hoeken/frothfet/frothfet/FrothFET Rev F Fuse Placement.png

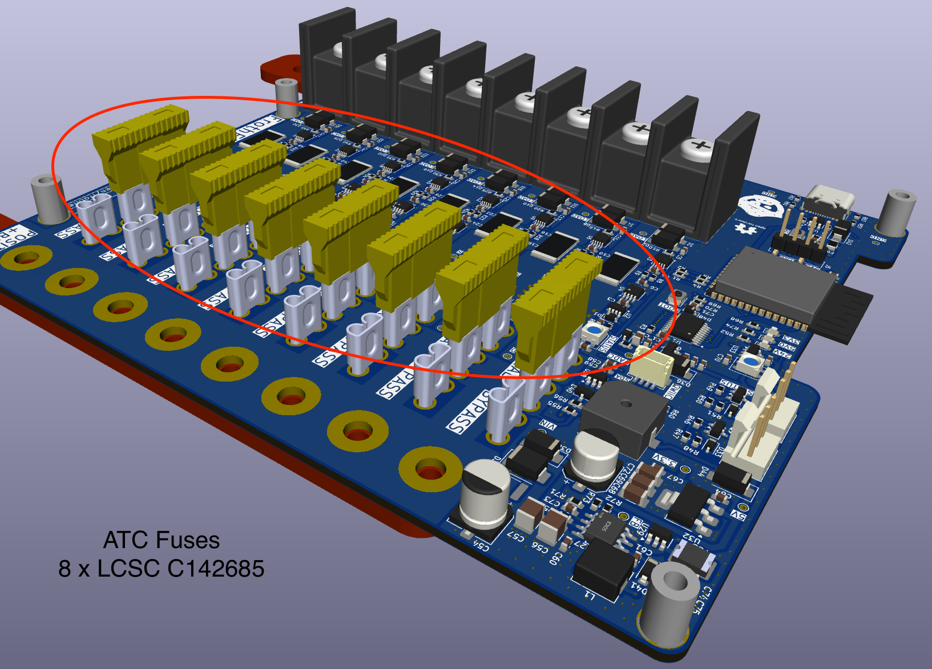
frothfet/FrothFET Rev F Fuse Placement.png
