hoeken/frothfet/frothfet/planning/ESP32-S3-DEV-KIT-N8R8-details-13.jpg

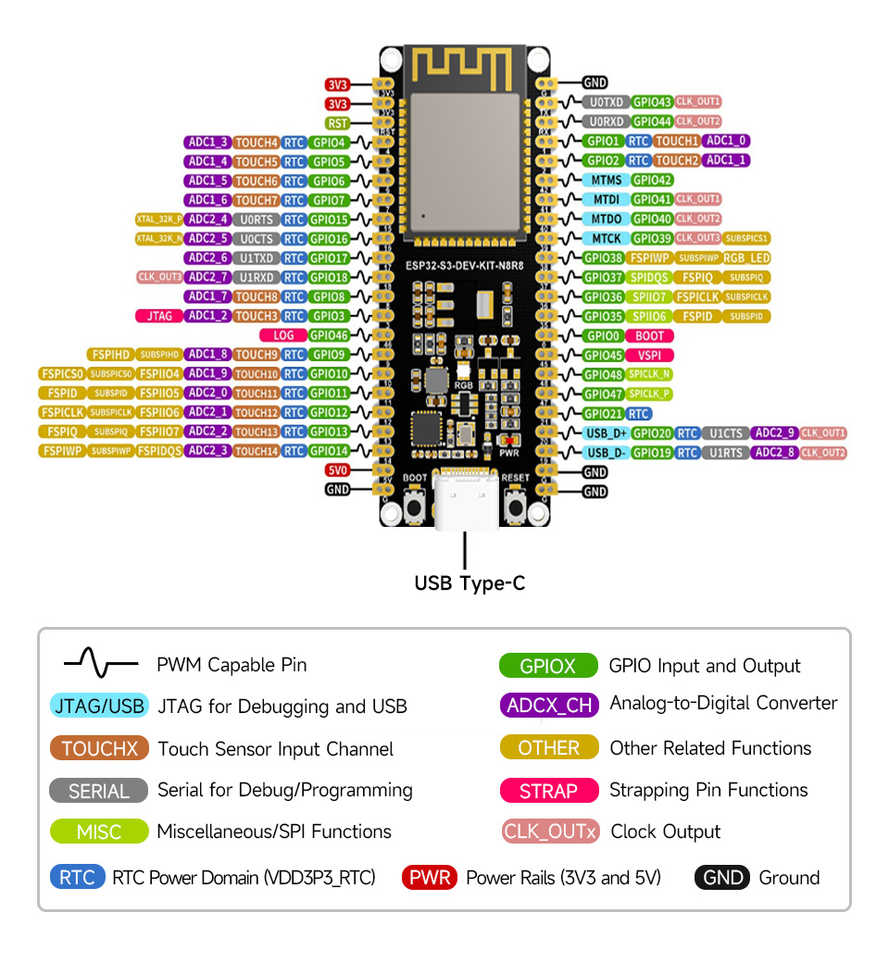
frothfet/planning/ESP32-S3-DEV-KIT-N8R8-details-13.jpg
