hoeken/frothfet/README.md

This is the hardware design repository for FrothFET.

For detailed documentation, please visit the [FrothFET documentation](https://frothfet.com).
