hoeken/frothfet/frothfet/planning/ADC chips.ods

Board/Chip | Price | Resolution | Sample Rate | Package | Supply | Arduino Sketch 8ch s/s
MCP3008 | 3.12 | 10 | 200k | DIP / SOIC | 2.7-5.5
MCP3208 | 4.97 | 12 | 100k | DIP / SOIC | 2.7-5.5 | 5755
ADS1115 | 6.46 | 16 | 860 | TINY | 2-5v | 14
ADS1015 | 3.06 | 12 | 3300 | TINY | 2-5v | 4
