hoeken/frothfet/frothfet/planning/current sense chips.ods

Board/Chip | Price | Package | Supply | Resistance | Accuracy | Bandwidth | Total
ACS724/5 | 4.36 | SOIC | 3.3v or 5v | 1.2mohm | ??? | 120kHz | $34.88
MCS1802/3 | 4.6 | SOIC | 3.3v or 5v | 0.9mohm | 2.50% | 80kHz | $36.80
TMCS1108 | 2.75 | SOIC | 3 V to 5.5 V | ??? | 1.00% | 100kHz | $22.00
CT415/CT427 | 5.91 | SOIC | 3.3v or 5v | ??? | 1.00% | 100kHz | $47.28
