hoeken/frothfet/frothfet/planning/cost reduction.ods

Sheet: Sheet1
Rev E Design |  | @100
chip | qty | cost | total
mcp3564r | 2 | $4.50 | $9.00
tmcs1108 | 8 | $1.50 | $12.00
passives | 208 | $0.01 | $2.08
total |  |  | $23.08
Rev F Design
chip | qty | cost | total
ina226 | 8 | $0.62 | $4.96
sense resistor | 8 | $0.40 | $3.20
74LVC541A | 1 | $0.20 | $0.20
LM75BDP | 8 | $0.38 | $3.04 | T1601B | DS18B20U(UMW)
total |  |  | $11.40
BTN8982TA | 8 | $2.38 | $19.04
LM74502H | 8 | $0.79 | $6.32
BSC010N04LS | 8 | $0.35 | $2.80
Infineon BTS6143D | 8 | $1.09 | $8.72
BTS50055-1TMA | 8 | $3.13 | $25.04

Sheet: FrothFET Mini
FrothFET Mini Design
chip | qty | cost | total
74LVC541A | 1 | -$0.20 | -$0.20
LM75BDP | 8 | -$0.38 | -$3.04
LM74502H | 8 | -$1.30 | -$10.40
BSC010N04LS | 8 | -$0.61 | -$4.88
T507 | 21 | -$0.04 | -$0.84
BTS724G | 4 | $1.74 | $6.96
PCA9685 | 1 | $2.55 | $2.55
total |  |  | -$9.85
