hoeken/frothfet/models/Positive Busbar Rev F.FCStd

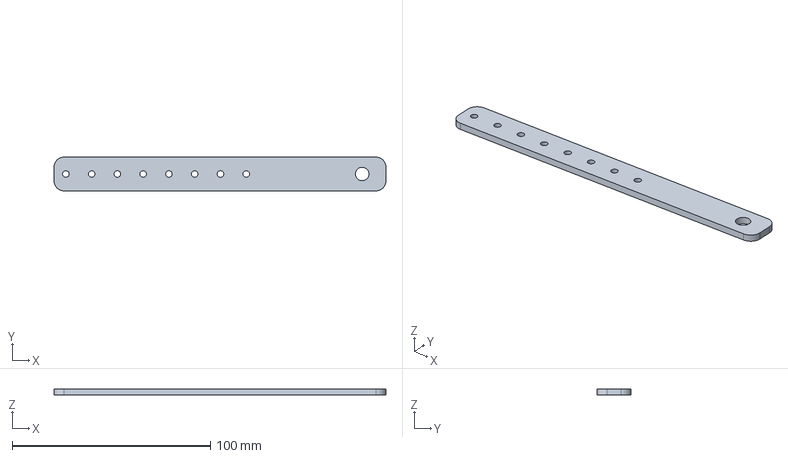
[picture p3: CAD file, 2025-10-06]
models/Positive Busbar Rev F.FCStd
167.5 x 17.0 x 3.12 mm
