hoeken/frothfet/models/Negative Busbar Rev F.FCStd

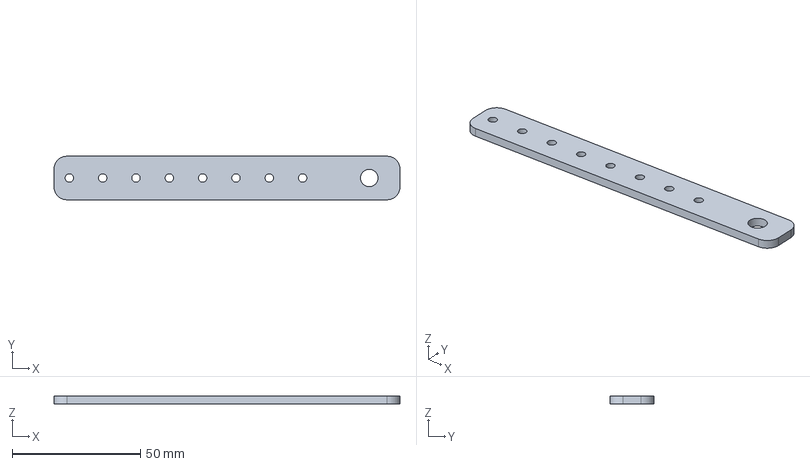
[picture p4: CAD file, 2024-11-02]
models/Negative Busbar Rev F.FCStd
135.0 x 17.0 x 3.12 mm
