hoeken/frothfet/MANUFACTURING.md

++ PCB Options

**If unspecified, use defaults:**

* PCB Color: Blue
* Surface Finish: ENIG
* Outer Copper Weight: 2oz

++ PCBA Options

**If unspecified, use defaults:**

* PCBA Type: Standard
* Bake Components: Yes
  * Comment: WS2812B-Mini (LCSC C527089)
* Depanel boards & edge rail: Yes
* PCBA Remark:
  * Please populate 8 x ATC Fuses (LCSC C142685) in NORMAL position as shown
  * Upload fuse placement image
