hoeken/frothfet/schematics/FrothFET Rev F.pdf

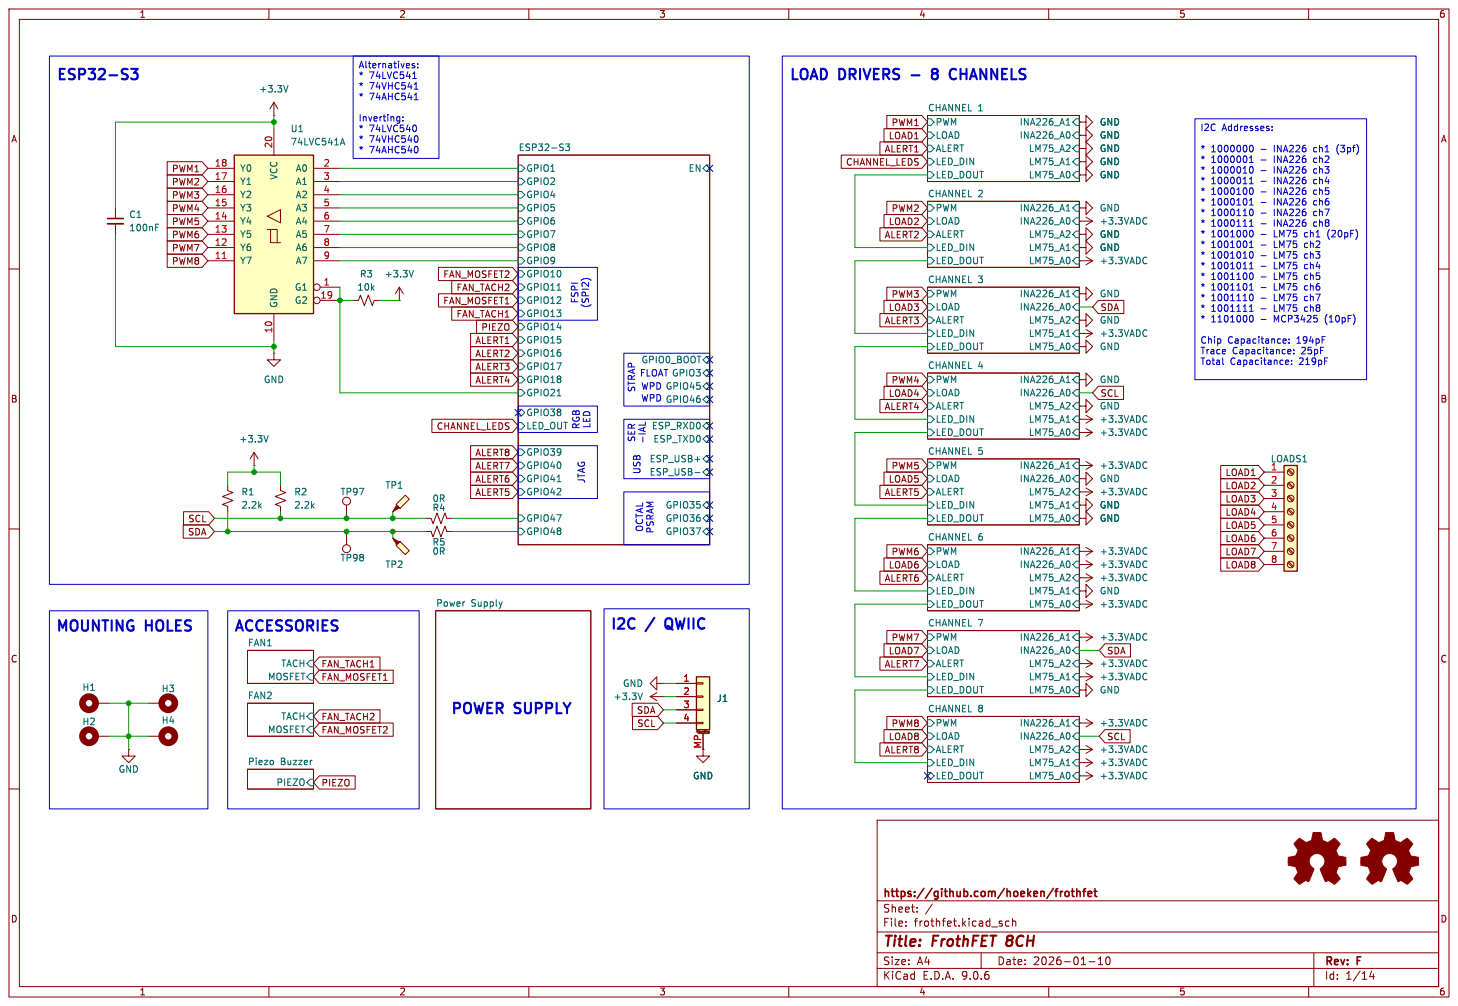
[picture p5: page 1]

File: frothfet.kicad_sch Sheet: / https://github.com/hoeken/frothfet

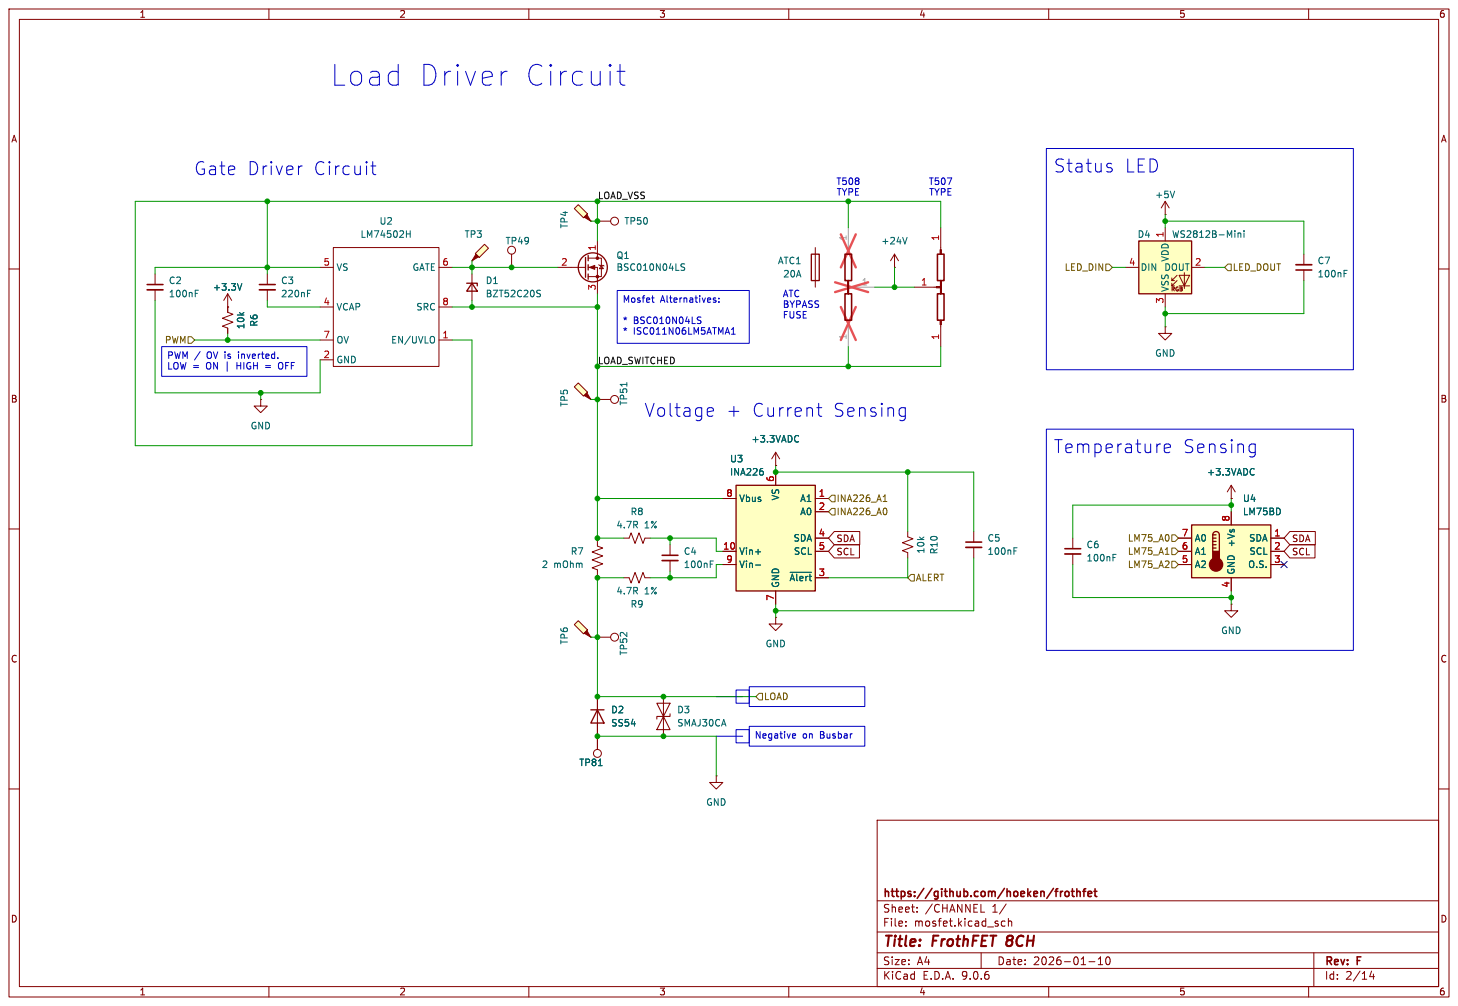
[picture p6: page 2]

T508 TYPE Load Driver Circuit
1 GND

Negative on Busbar Mosfet Alternatives: * BSC010N04LS

* ISC011N06LM5ATMA1 PWM / OV is inverted. LOW = ON | HIGH = OFF
INA226_A1 PWM

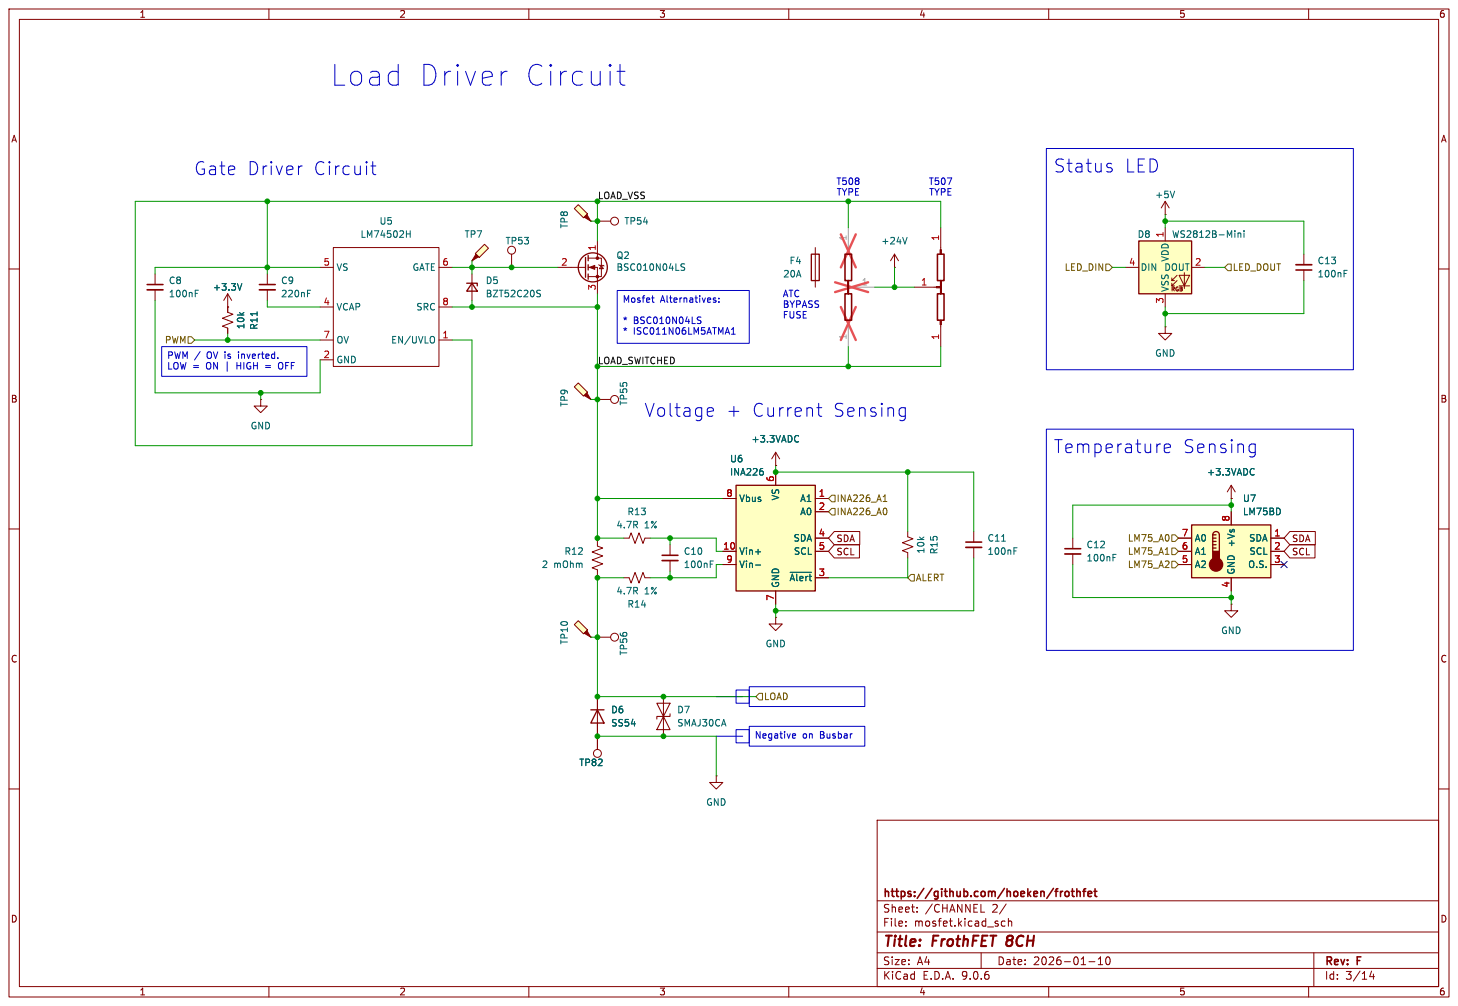
[picture p7: page 3]

T508 TYPE Load Driver Circuit
1 GND

1 3 Q2 BSC010N04LS 10k R11 VS 5 VCAP 4 OV 7 GND 2 GATE 6 SRC 8 EN/UVLO 1 U5

Negative on Busbar Mosfet Alternatives: * BSC010N04LS

* ISC011N06LM5ATMA1 PWM / OV is inverted. LOW = ON | HIGH = OFF
INA226_A1 PWM

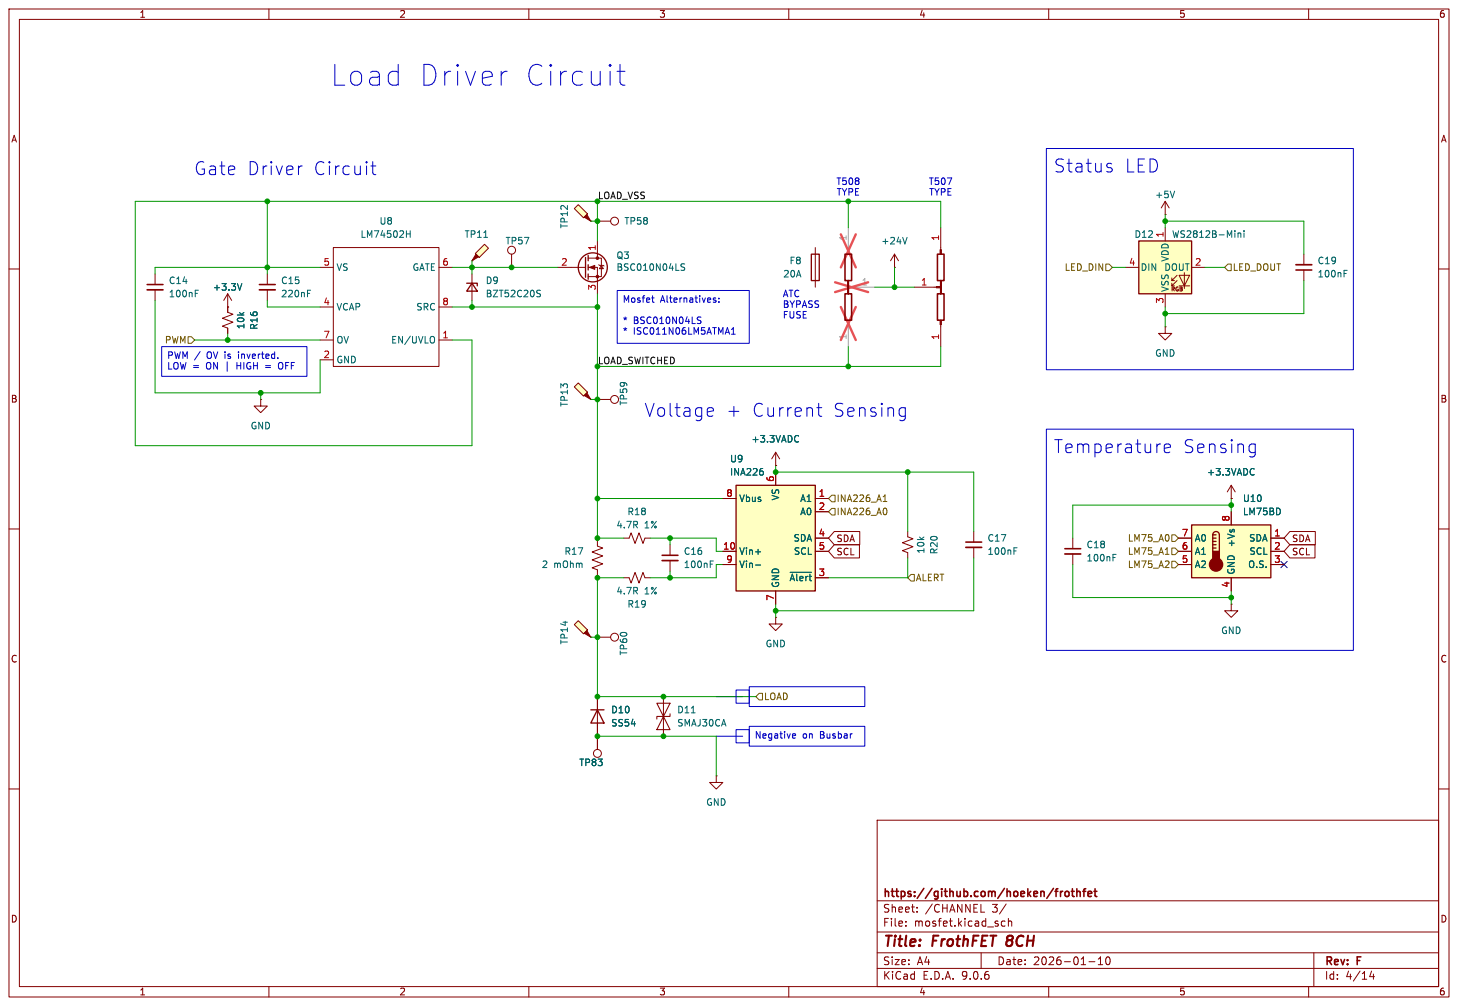
[picture p8: page 4]

T508 TYPE Load Driver Circuit
1 GND

Negative on Busbar Mosfet Alternatives: * BSC010N04LS

* ISC011N06LM5ATMA1 PWM / OV is inverted. LOW = ON | HIGH = OFF
INA226_A1 PWM

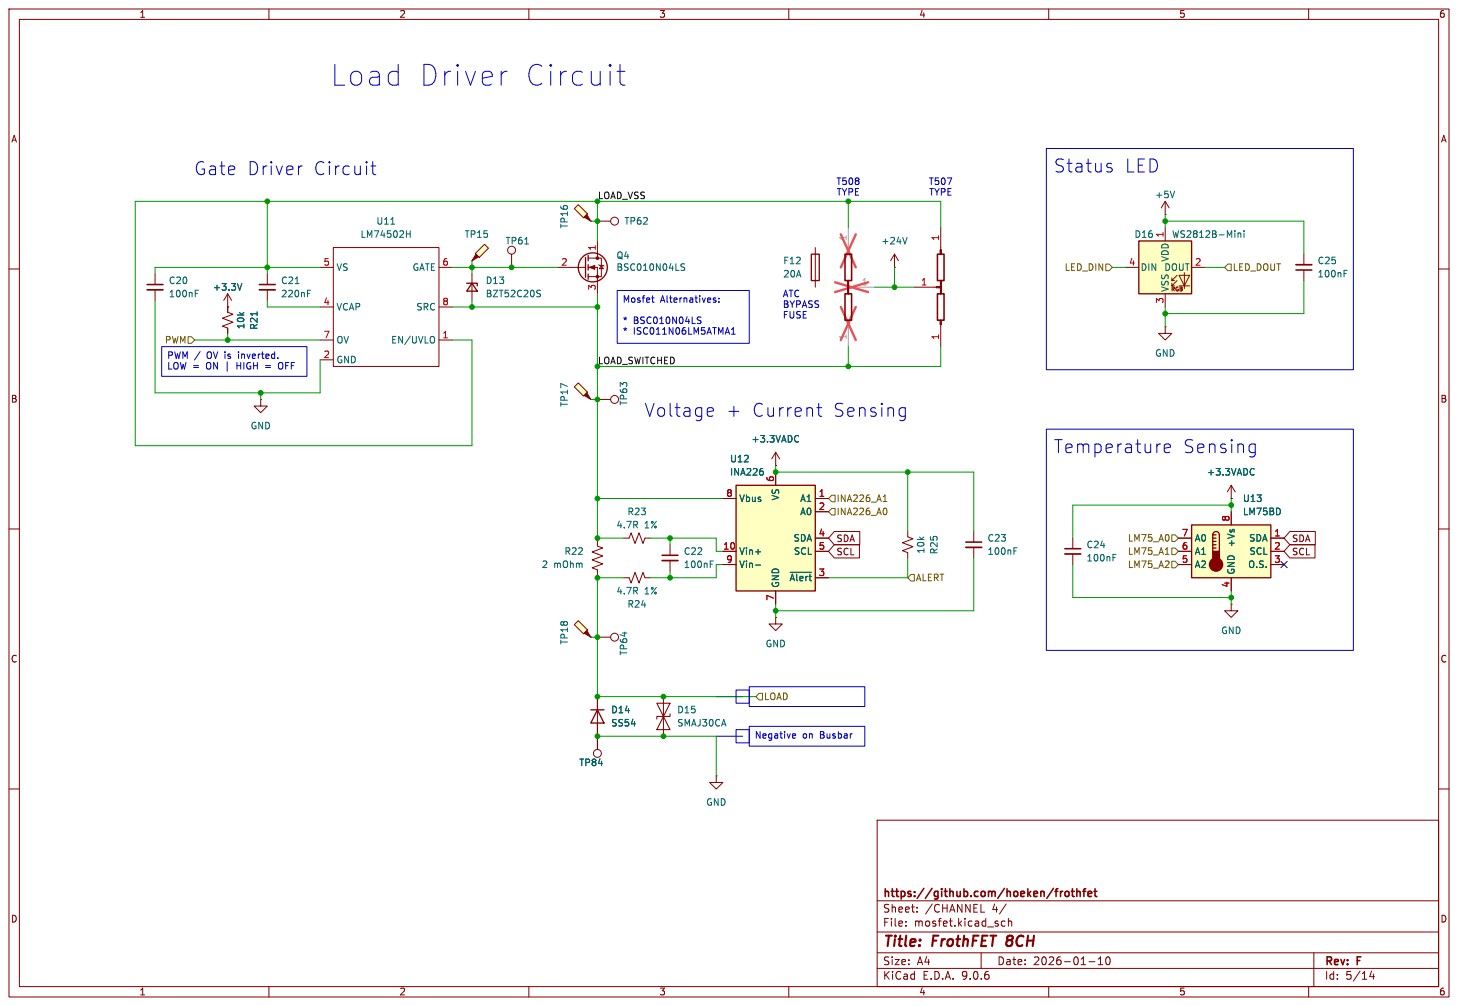
[picture p9: page 5]

T508 TYPE Load Driver Circuit
1 GND

1 3 Q4 BSC010N04LS 10k R21 VS 5 VCAP 4 OV 7 GND 2 GATE 6 SRC 8 EN/UVLO 1 U11

Negative on Busbar Mosfet Alternatives: * BSC010N04LS

* ISC011N06LM5ATMA1 PWM / OV is inverted. LOW = ON | HIGH = OFF
INA226_A1 PWM

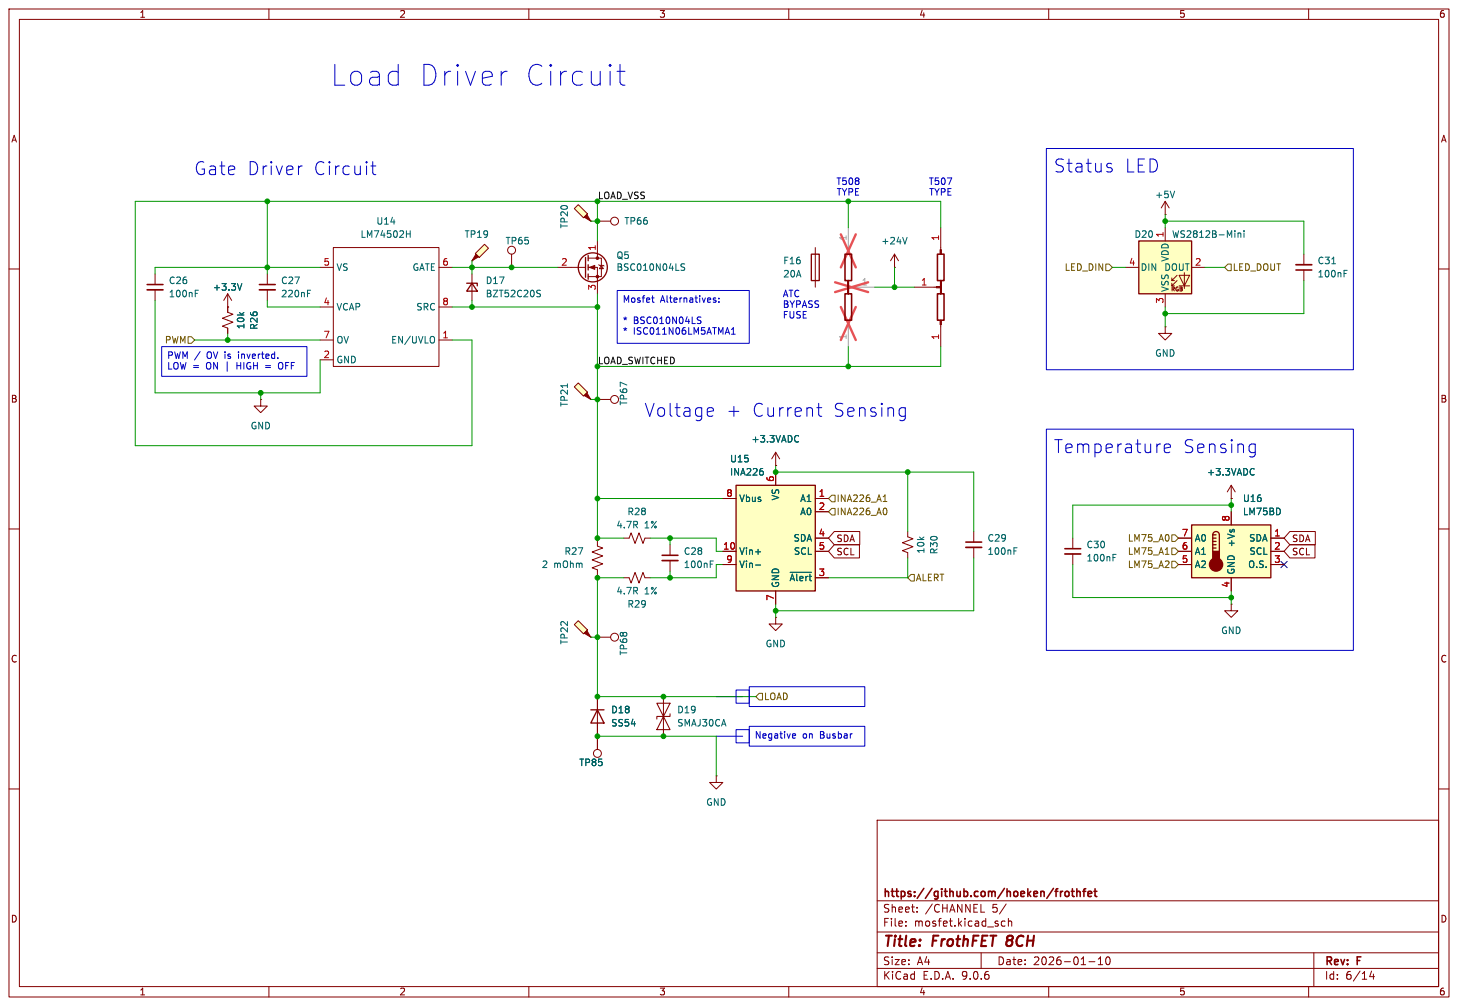
[picture p10: page 6]

T508 TYPE Load Driver Circuit
1 GND

Negative on Busbar Mosfet Alternatives: * BSC010N04LS

* ISC011N06LM5ATMA1 PWM / OV is inverted. LOW = ON | HIGH = OFF
INA226_A1 PWM

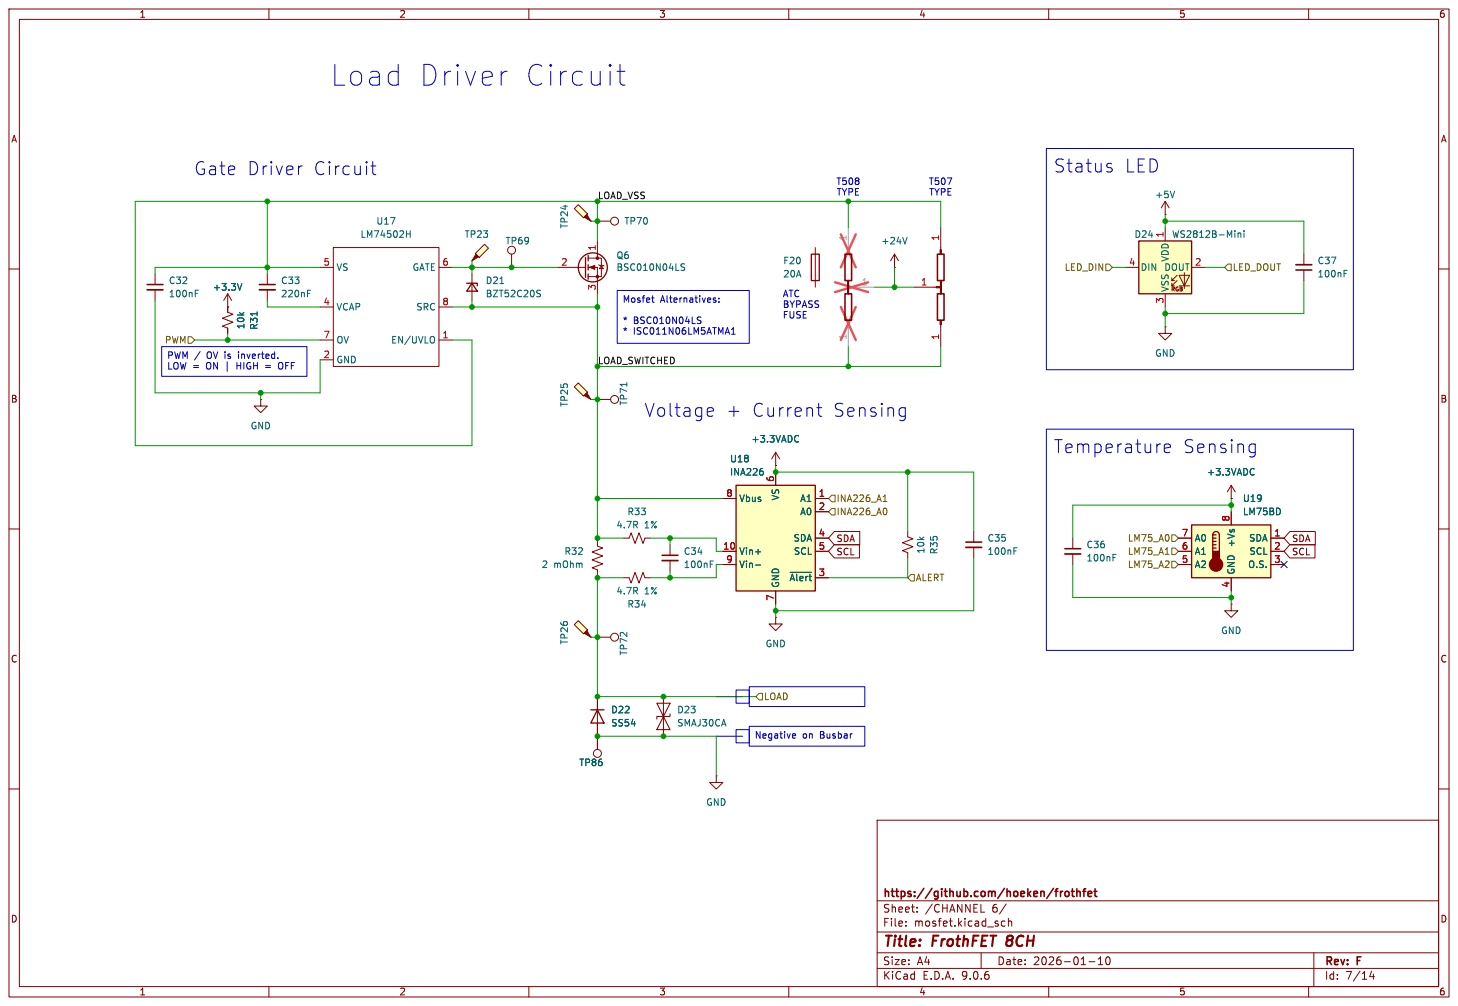
[picture p11: page 7]

T508 TYPE Load Driver Circuit
1 GND

1 3 Q6 BSC010N04LS 10k R31 VS 5 VCAP 4 OV 7 GND 2 GATE 6 SRC 8 EN/UVLO 1 U17

Negative on Busbar Mosfet Alternatives: * BSC010N04LS

* ISC011N06LM5ATMA1 PWM / OV is inverted. LOW = ON | HIGH = OFF
INA226_A1 PWM

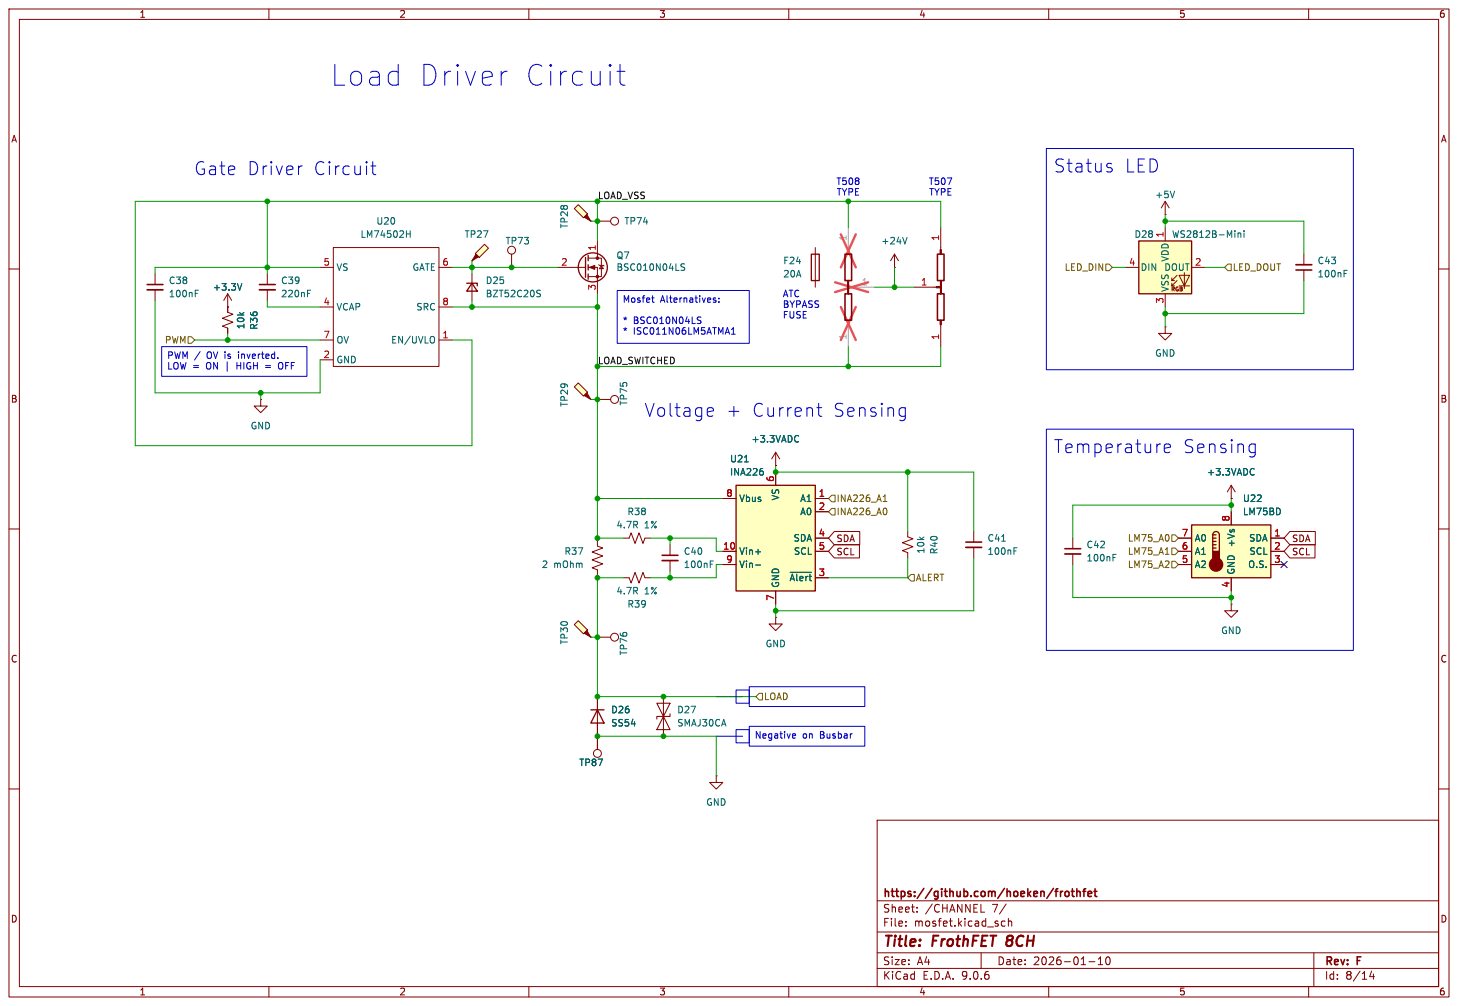
[picture p12: page 8]

T508 TYPE Load Driver Circuit
1 GND

Negative on Busbar Mosfet Alternatives: * BSC010N04LS

* ISC011N06LM5ATMA1 PWM / OV is inverted. LOW = ON | HIGH = OFF
INA226_A1 PWM

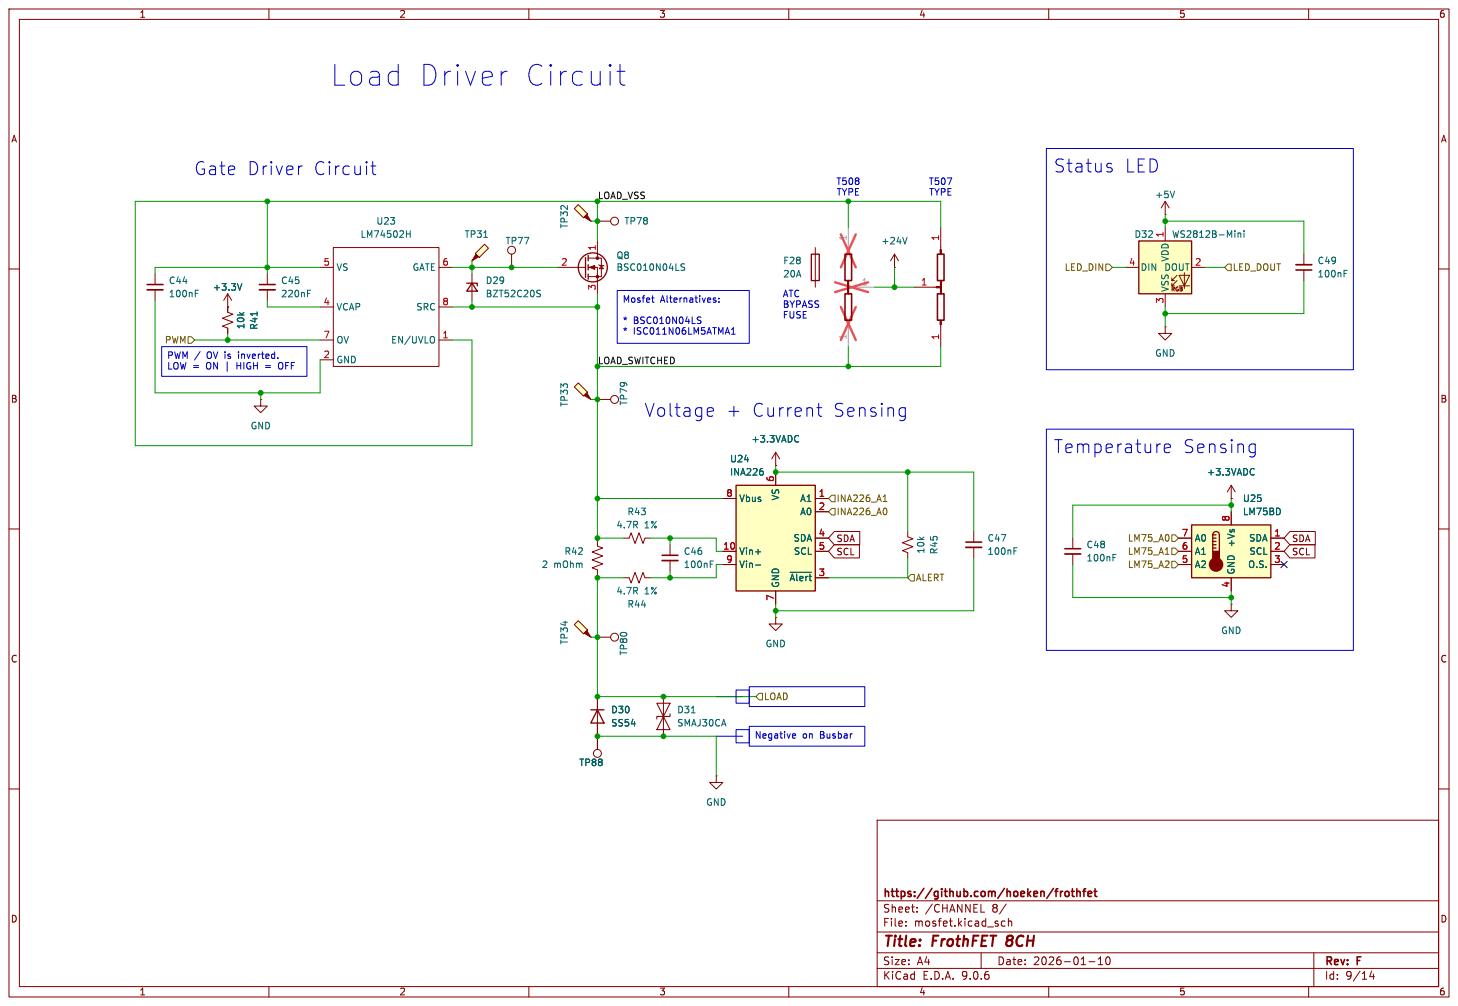
[picture p13: page 9]

T508 TYPE Load Driver Circuit
1 GND

1 3 Q8 BSC010N04LS 10k R41 VS 5 VCAP 4 OV 7 GND 2 GATE 6 SRC 8 EN/UVLO 1 U23

Negative on Busbar Mosfet Alternatives: * BSC010N04LS

* ISC011N06LM5ATMA1 PWM / OV is inverted. LOW = ON | HIGH = OFF
INA226_A1 PWM

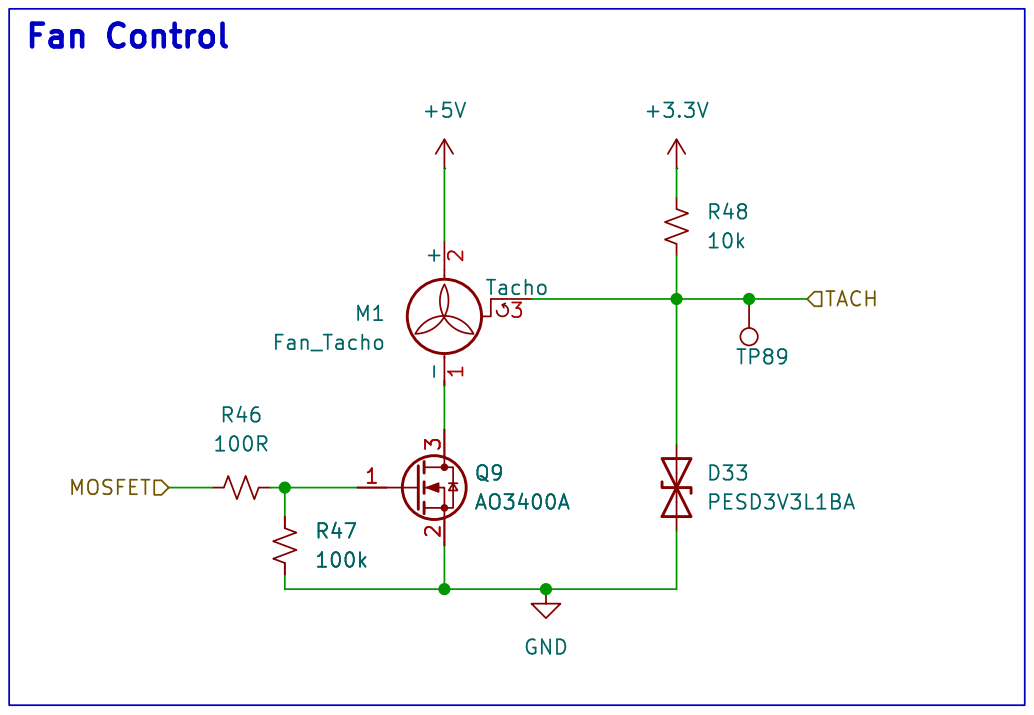
[picture p14: page 10]

File: pwm fan.kicad_sch Sheet: /FAN1/ https://github.com/hoeken/frothfet

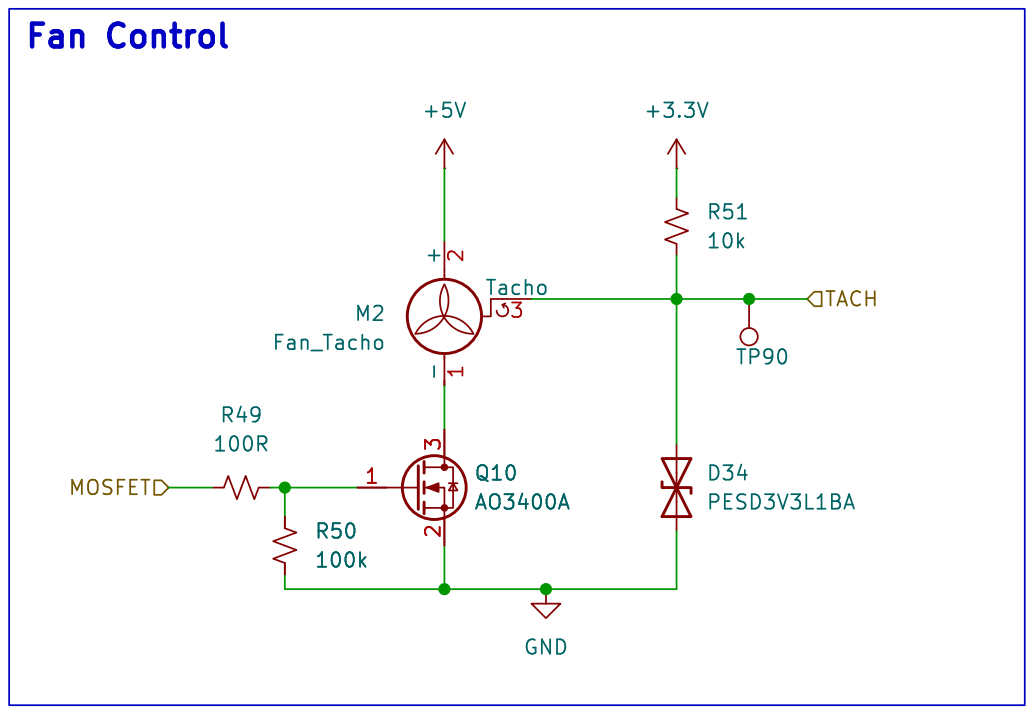
[picture p15: page 11]

File: pwm fan.kicad_sch Sheet: /FAN2/ https://github.com/hoeken/frothfet

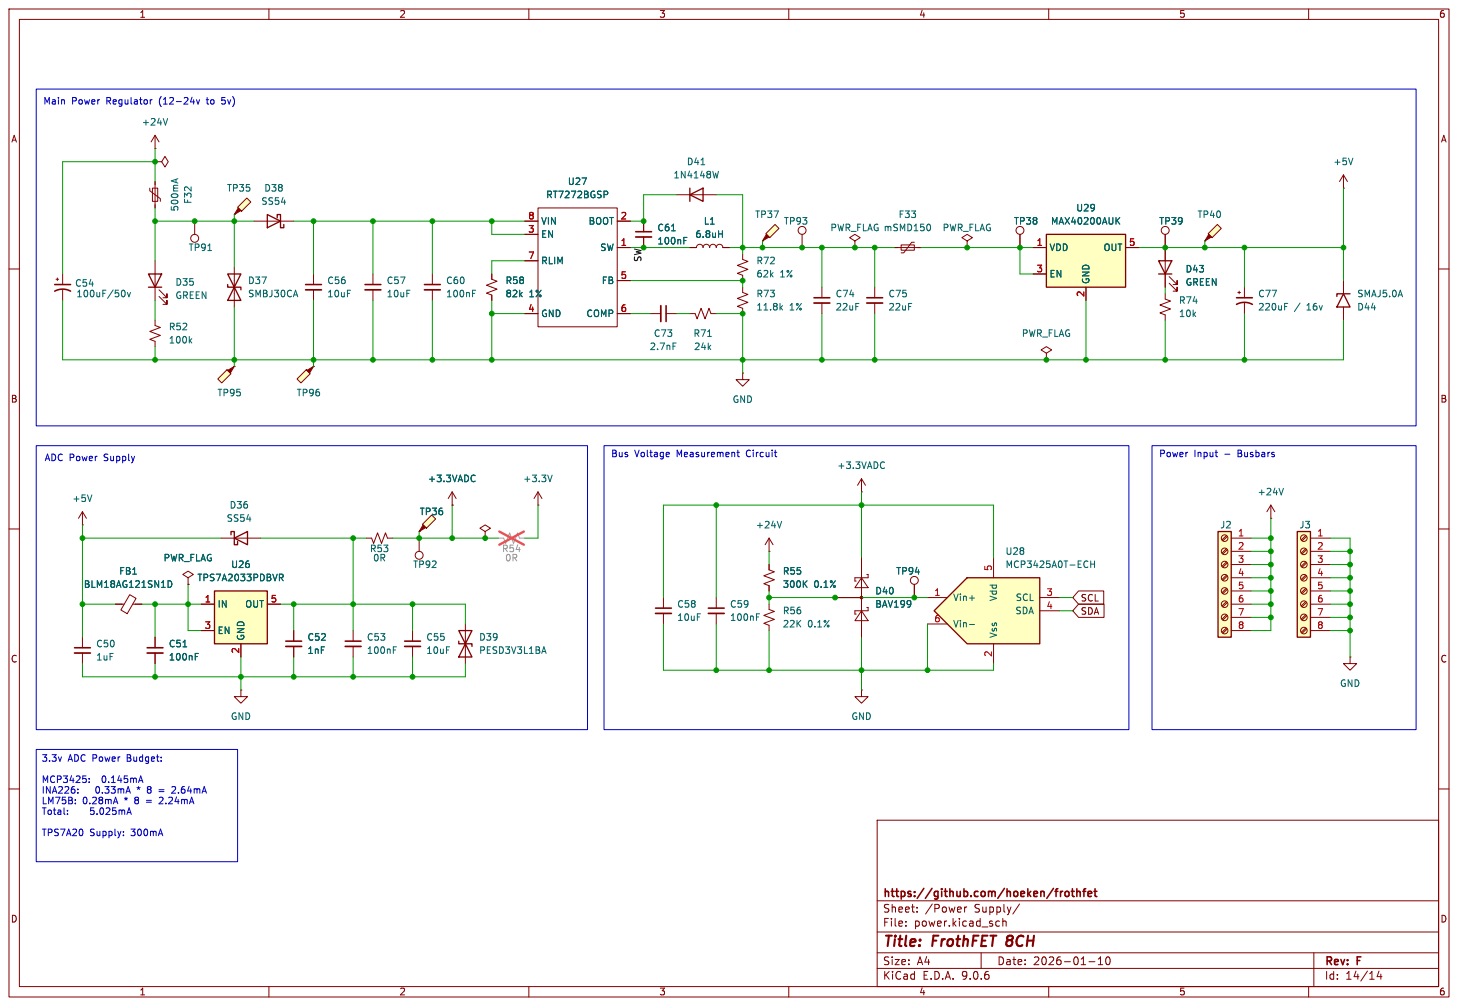
[picture p16: page 12]

5 Vss 2 SCL 3 SDA 4 U28 MCP3425A0T-ECH

https://github.com/hoeken/frothfet FB1 BLM18AG121SN1D

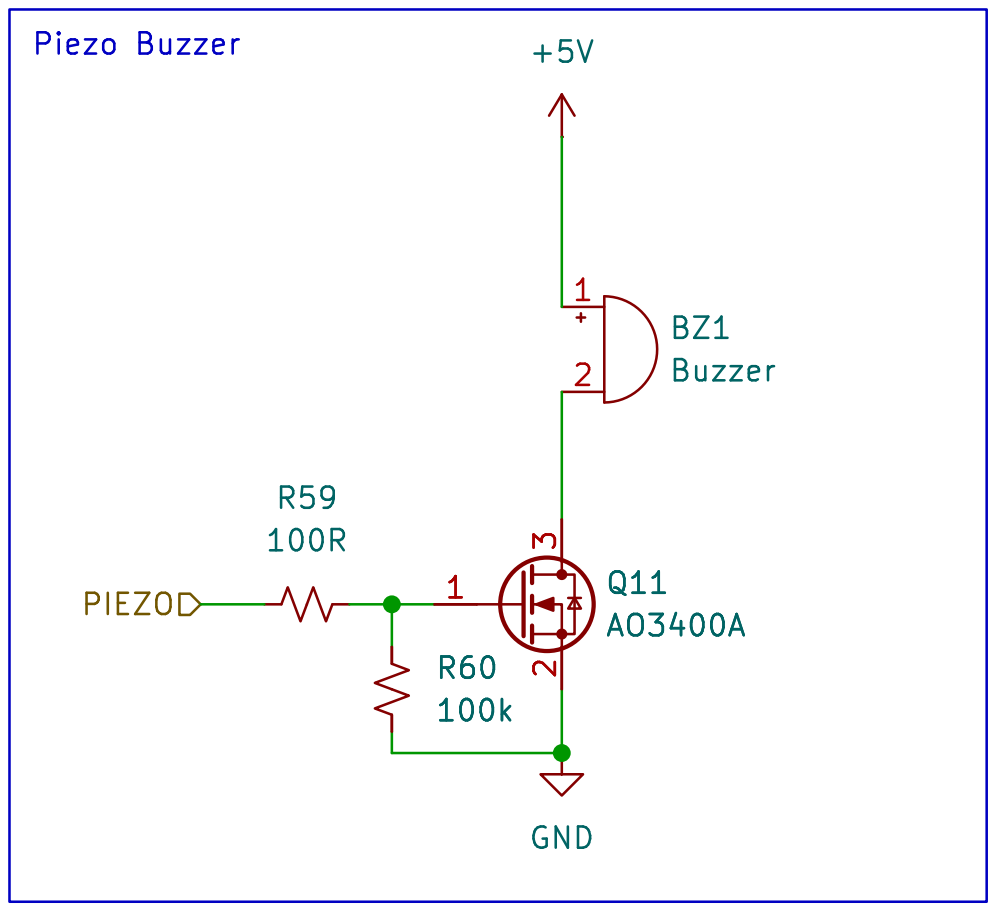
[picture p17: page 13]

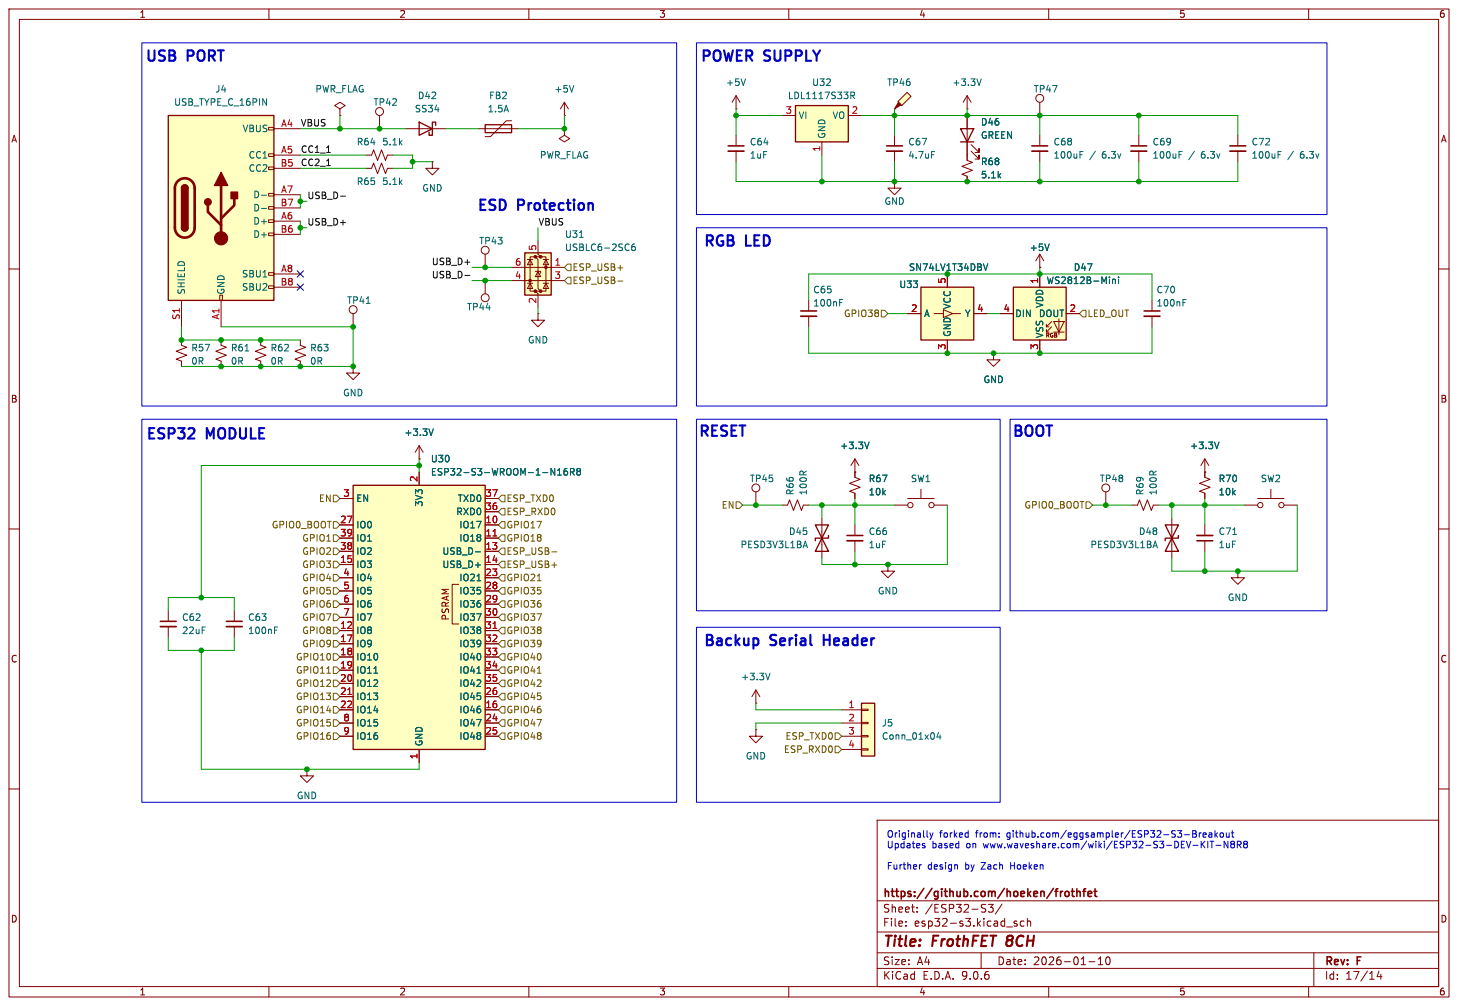
[picture p18: page 14]

Updates based on www.waveshare.com/wiki/ESP32-S3-DEV-KIT-N8R8 Further design by Zach Hoeken BOOT

File: esp32-s3.kicad_sch Sheet: /ESP32-S3/ https://github.com/hoeken/frothfet
