hoeken/frothfet/schematics/FrothFET Rev E.pdf

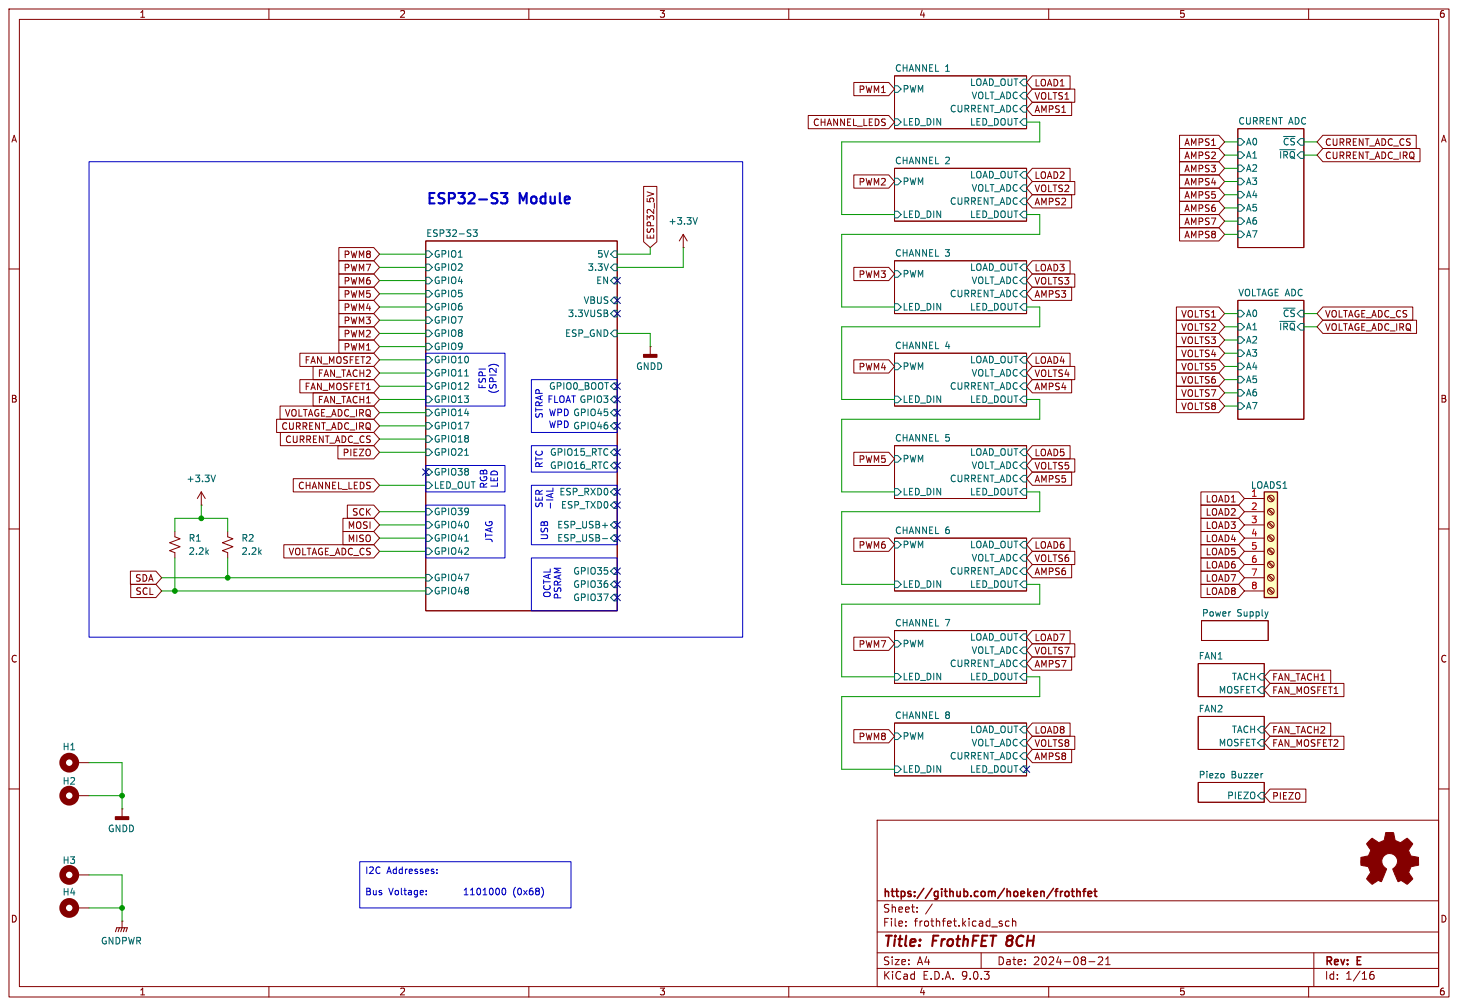
[picture p19: page 1]

VOLTS1 AMPS1
~{IRQ} CURRENT ADC MOSFET

File: frothfet.kicad_sch Sheet: / https://github.com/hoeken/frothfet

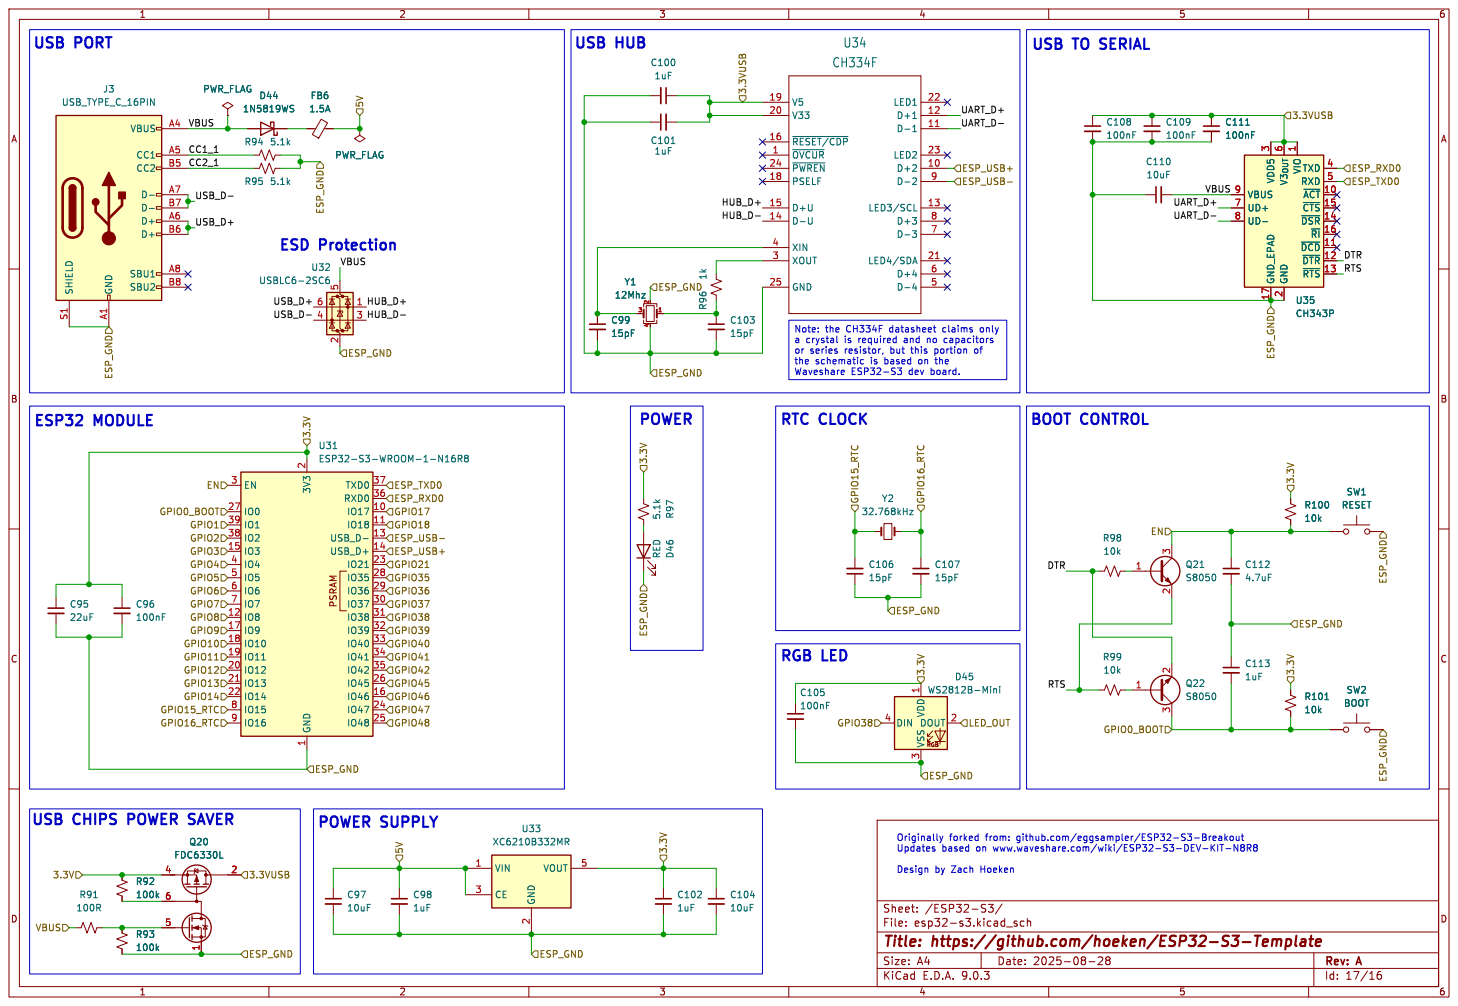
[picture p20: page 2]

1 TXD 4 RXD 5 ~{ACT} 10 ~{CTS} 15 ~{DSR} 14 ~{RI} 16 ~{DCD} 11 ~{DTR} 12 ~{RTS} 13 C111

1 TXD 4 RXD 5 ~{ACT} 10 ~{CTS} 15 ~{DSR} 14 ~{RI} 16 ~{DCD} 11 ~{DTR} 12 ~{RTS} 13 U35 CH343P C106

USB CHIPS POWER SAVER

Updates based on www.waveshare.com/wiki/ESP32-S3-DEV-KIT-N8R8 Design by Zach Hoeken

File: esp32-s3.kicad_sch Sheet: /ESP32-S3/
Id: 17/16 Title: https://github.com/hoeken/ESP32-S3-Template

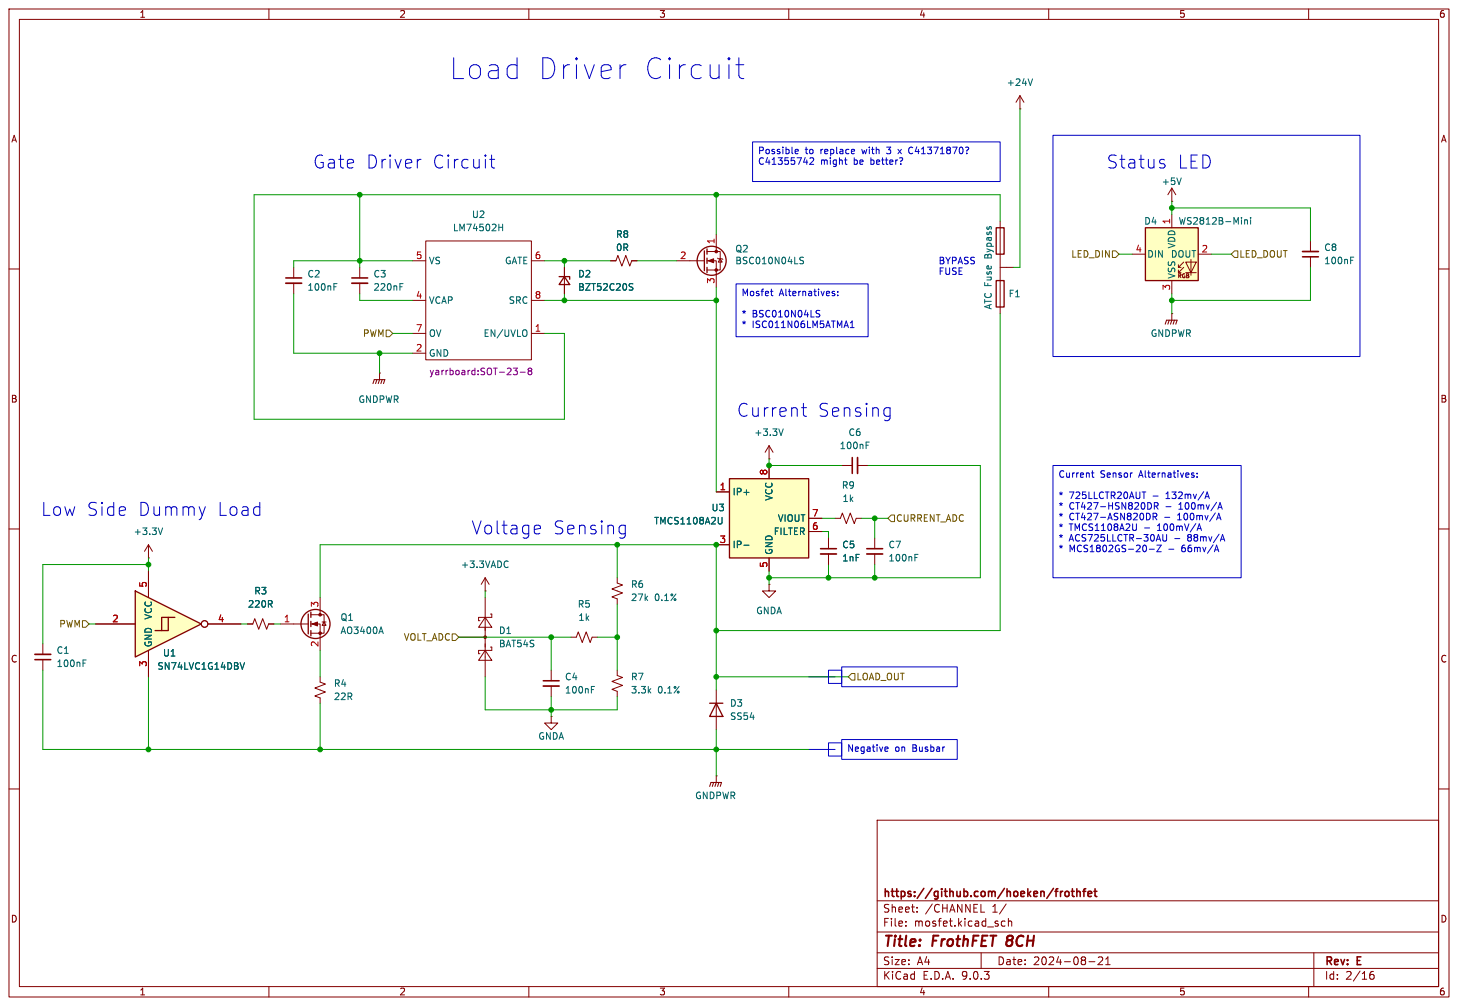
[picture p21: page 3]

Low Side Dummy Load

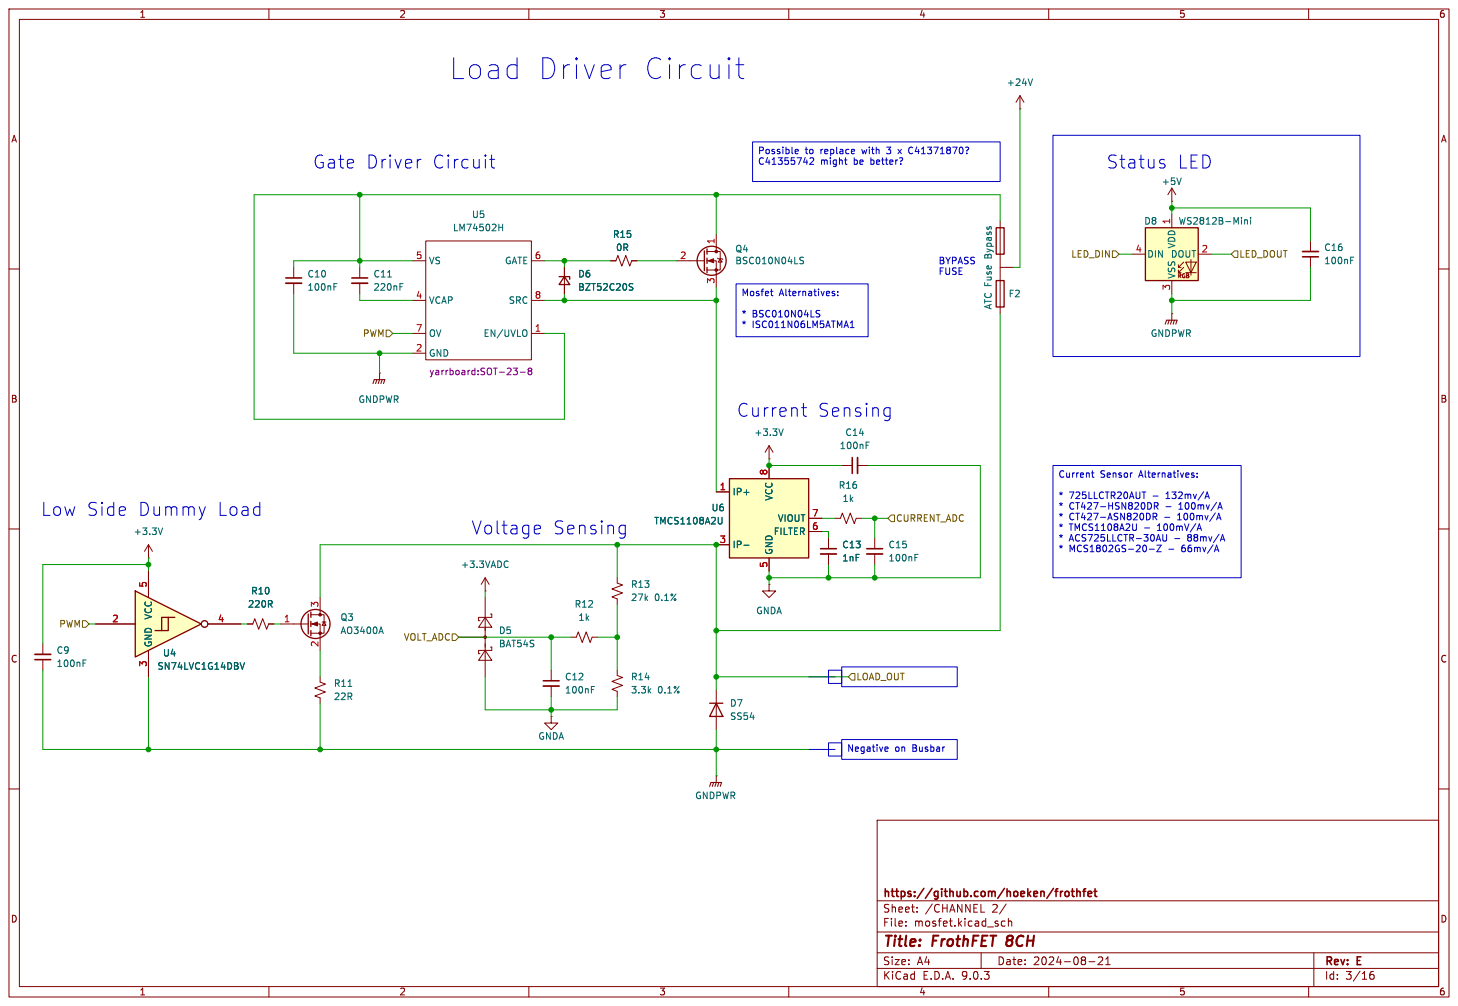
[picture p22: page 4]

Low Side Dummy Load

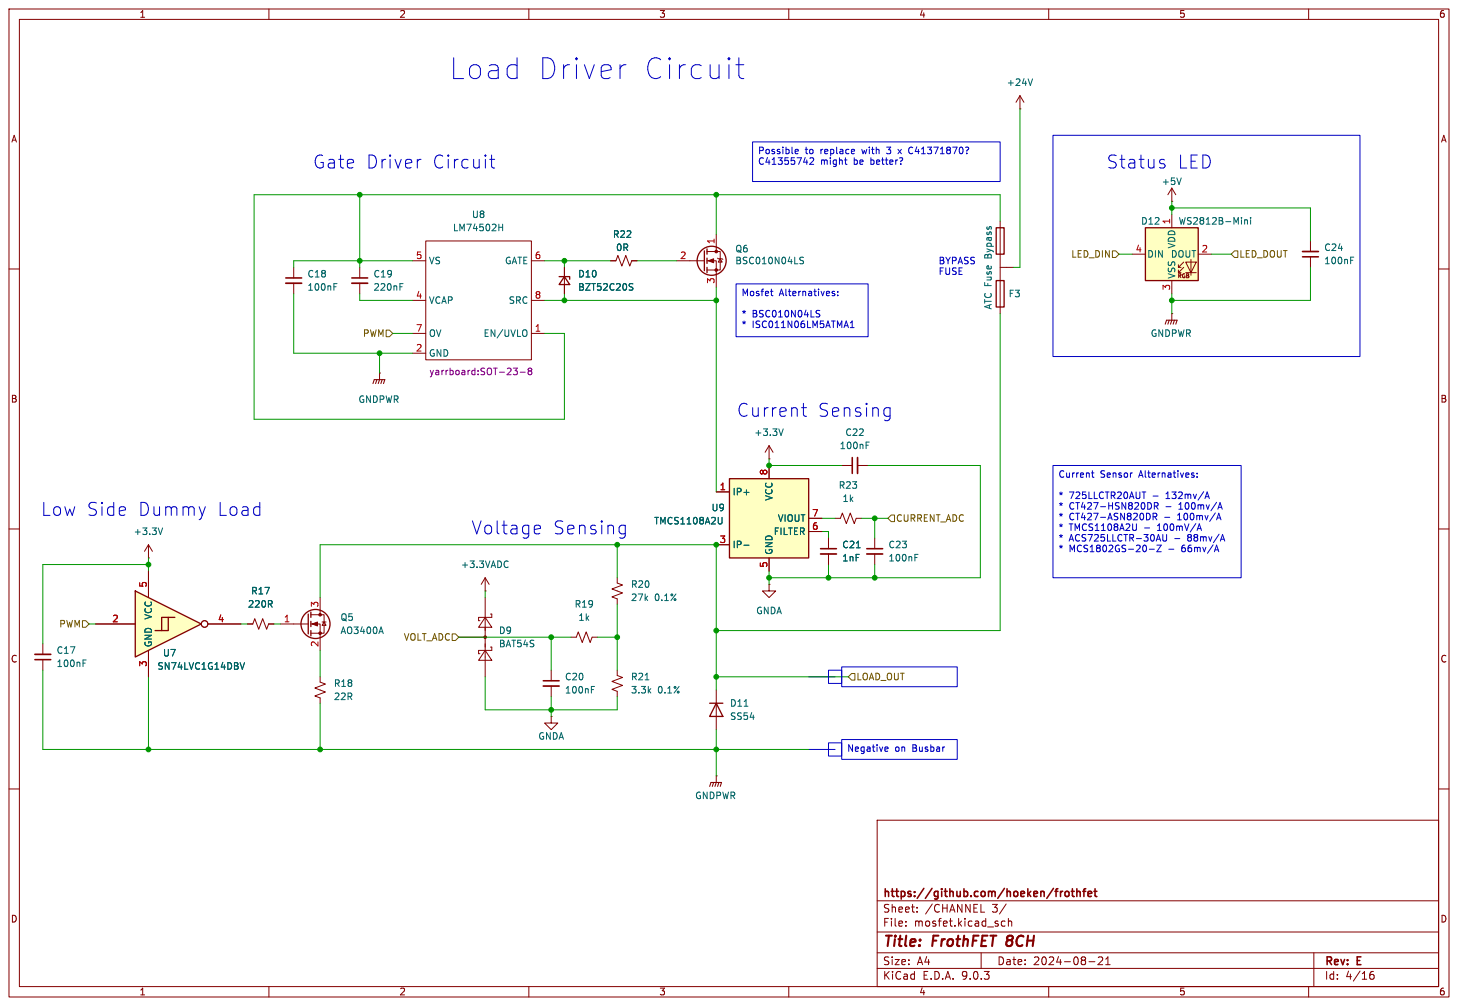
[picture p23: page 5]

Low Side Dummy Load

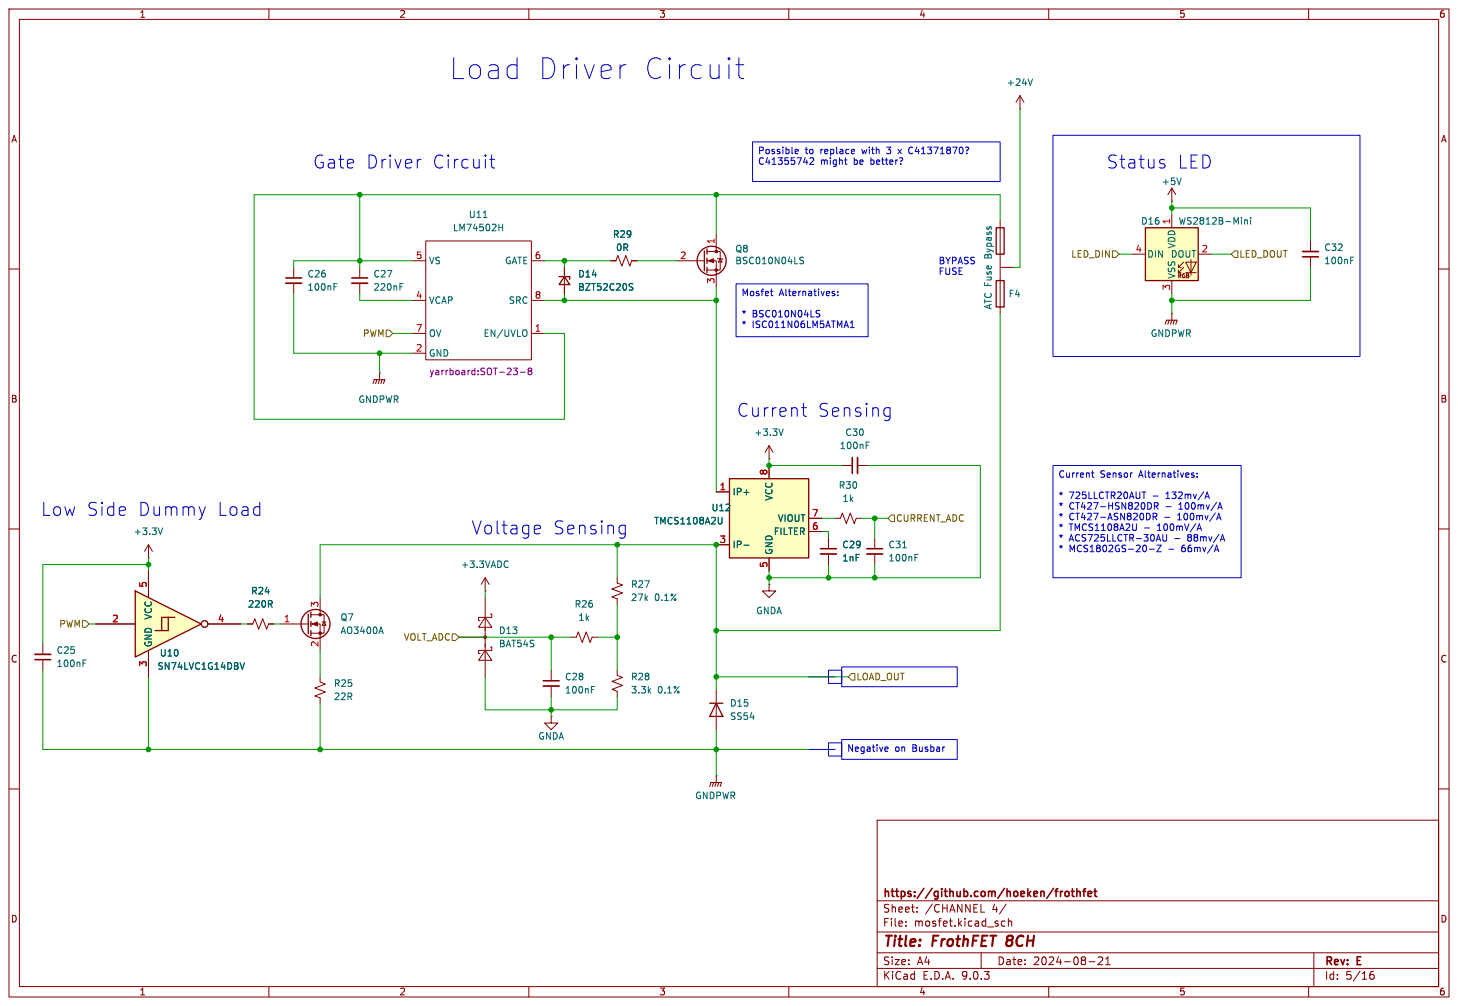
[picture p24: page 6]

Low Side Dummy Load

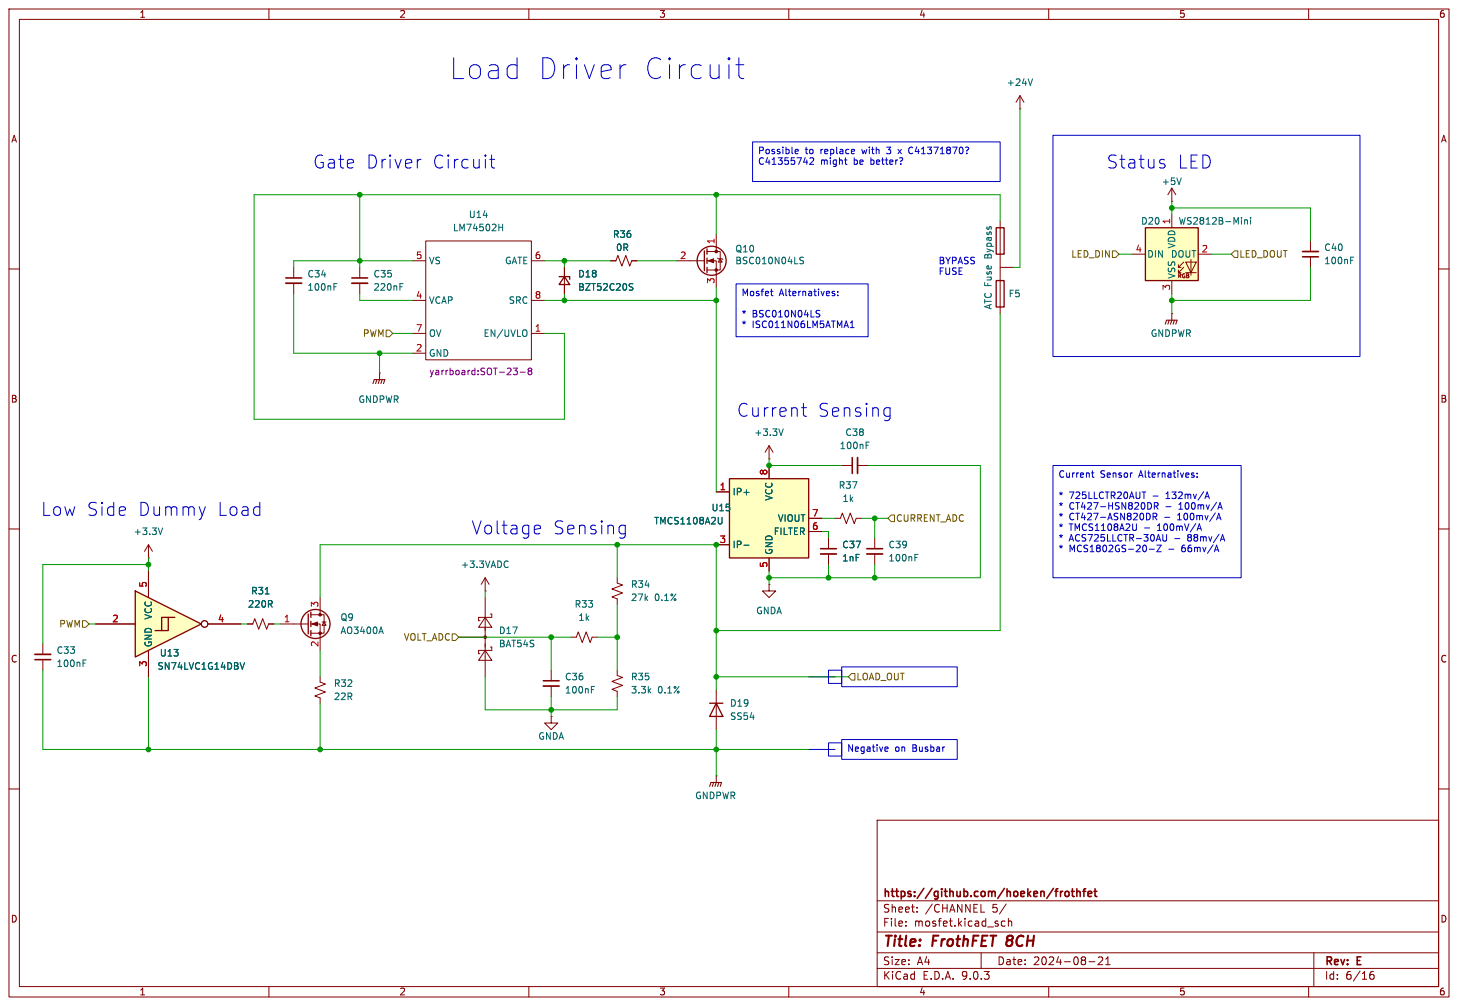
[picture p25: page 7]

Low Side Dummy Load

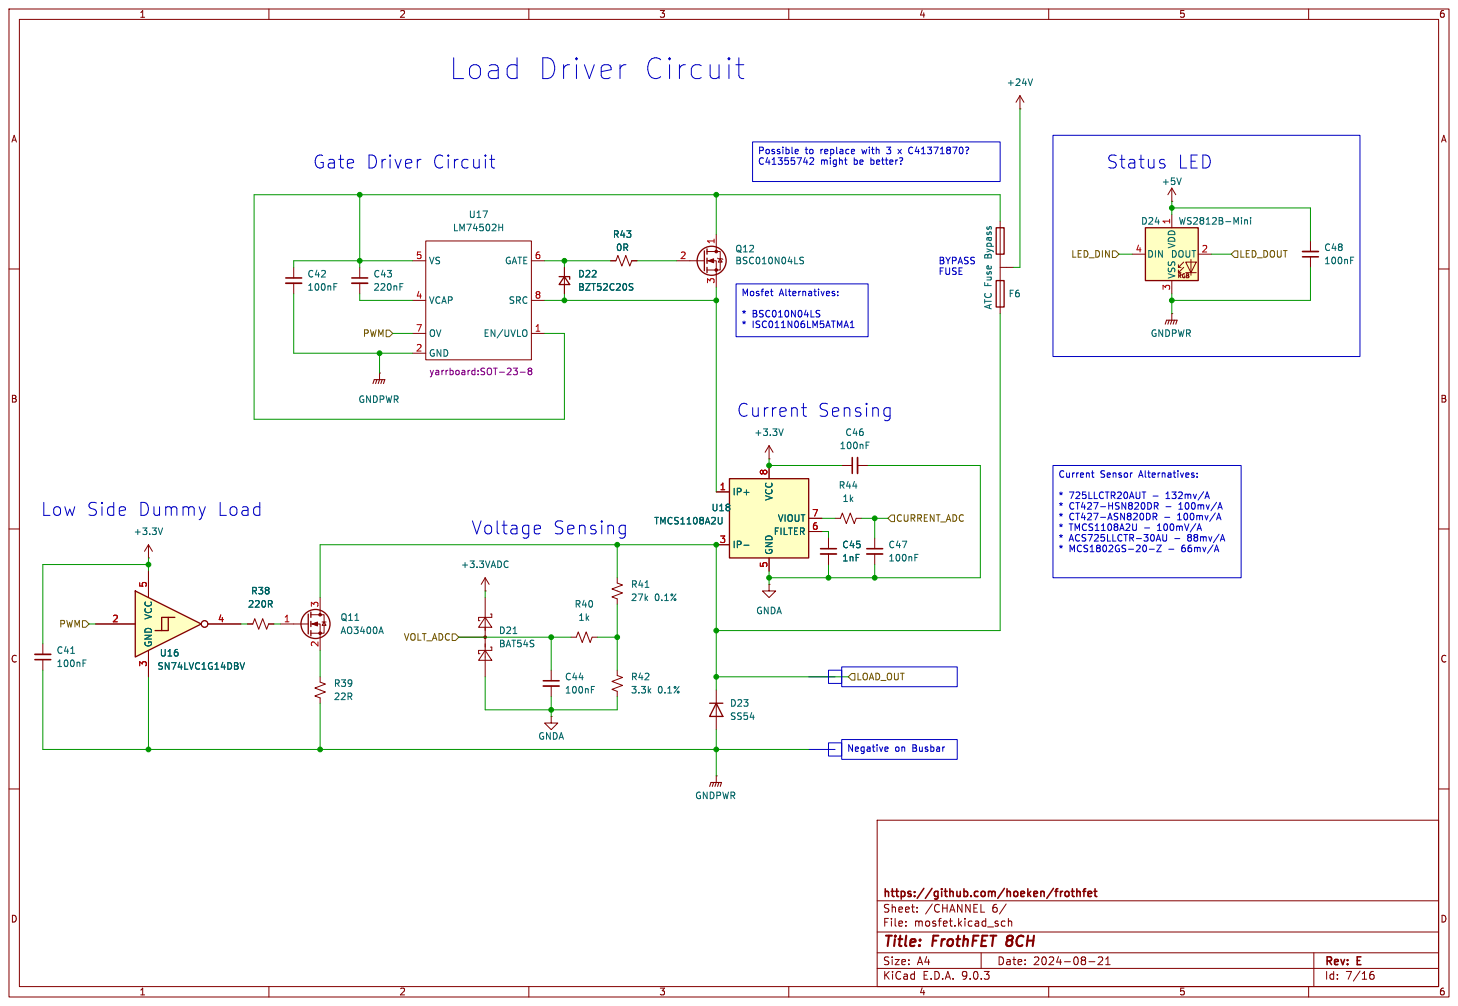
[picture p26: page 8]

Low Side Dummy Load

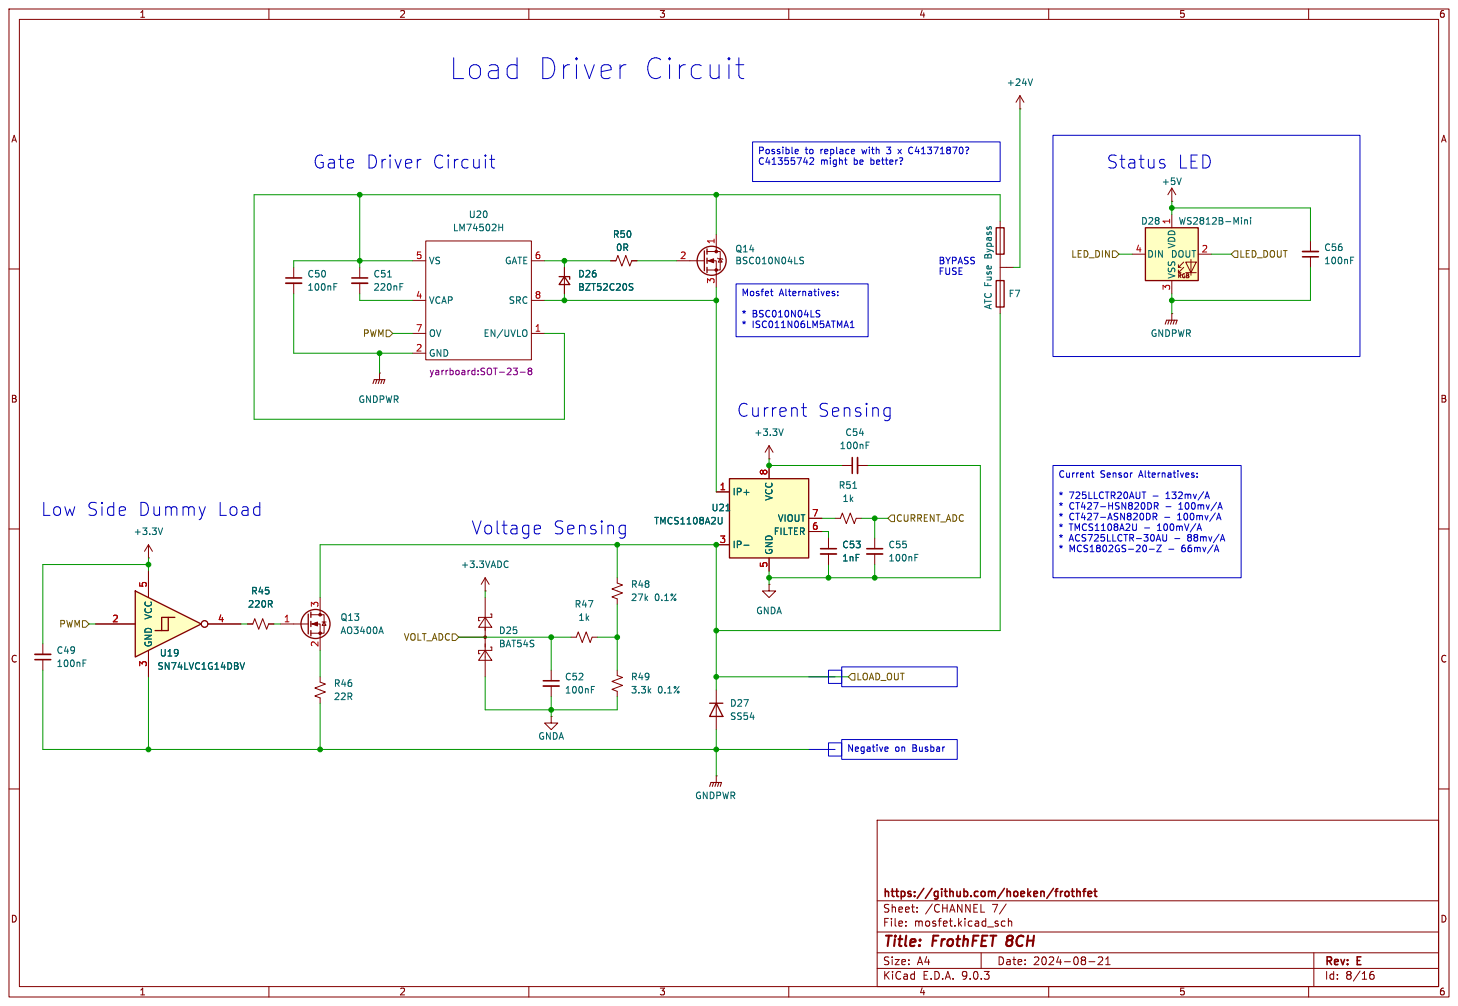
[picture p27: page 9]

Low Side Dummy Load

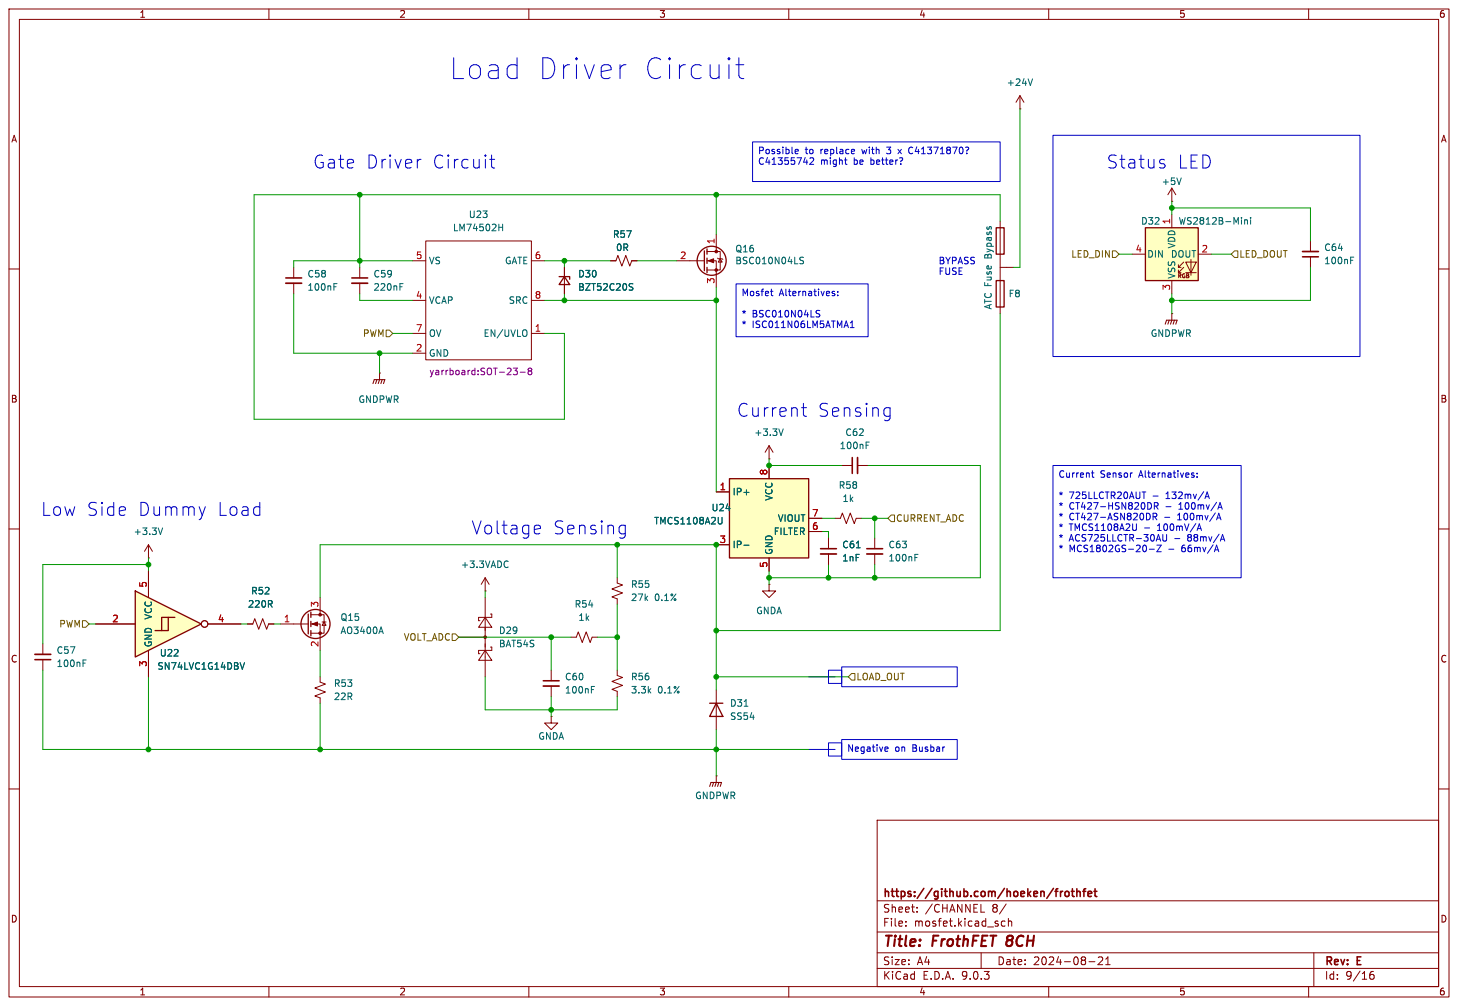
[picture p28: page 10]

Low Side Dummy Load

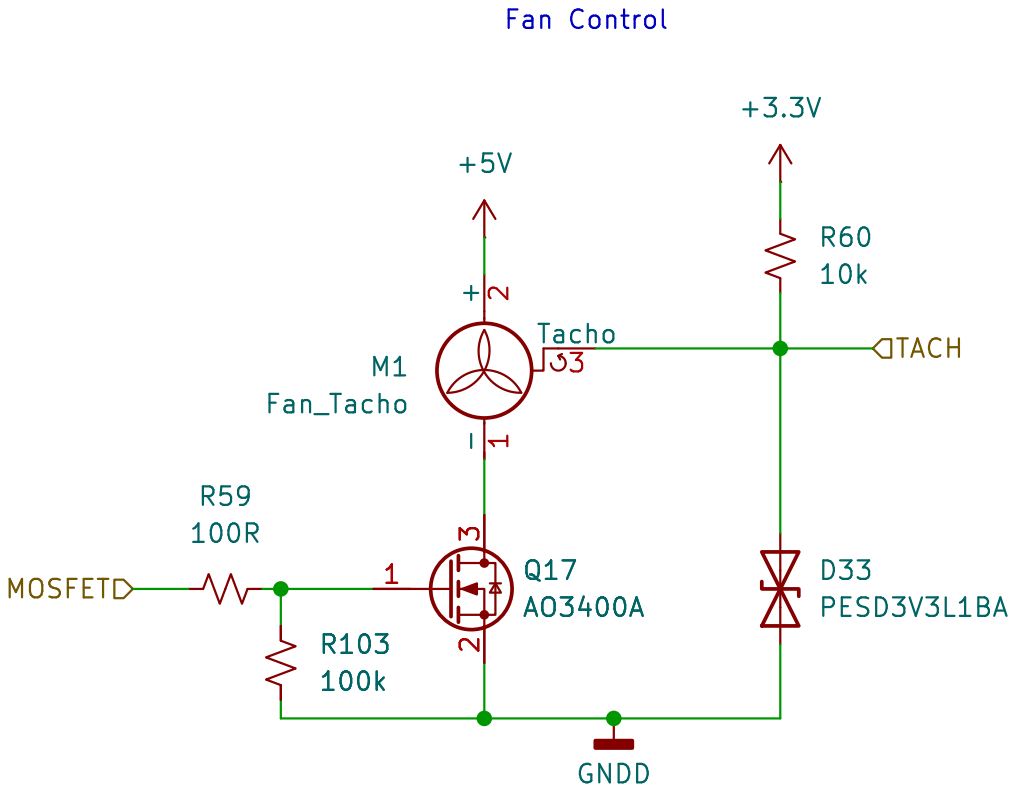
[picture p29: page 11]

File: pwm fan.kicad_sch Sheet: /FAN1/ https://github.com/hoeken/frothfet

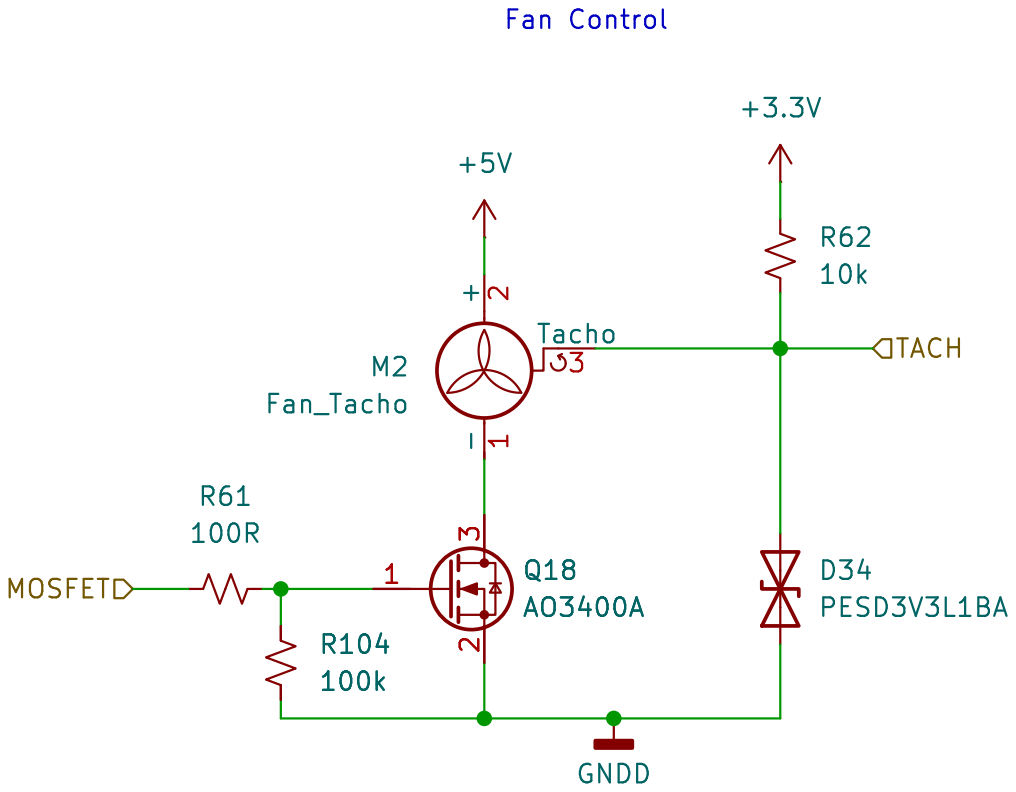
[picture p30: page 12]

File: pwm fan.kicad_sch Sheet: /FAN2/ https://github.com/hoeken/frothfet

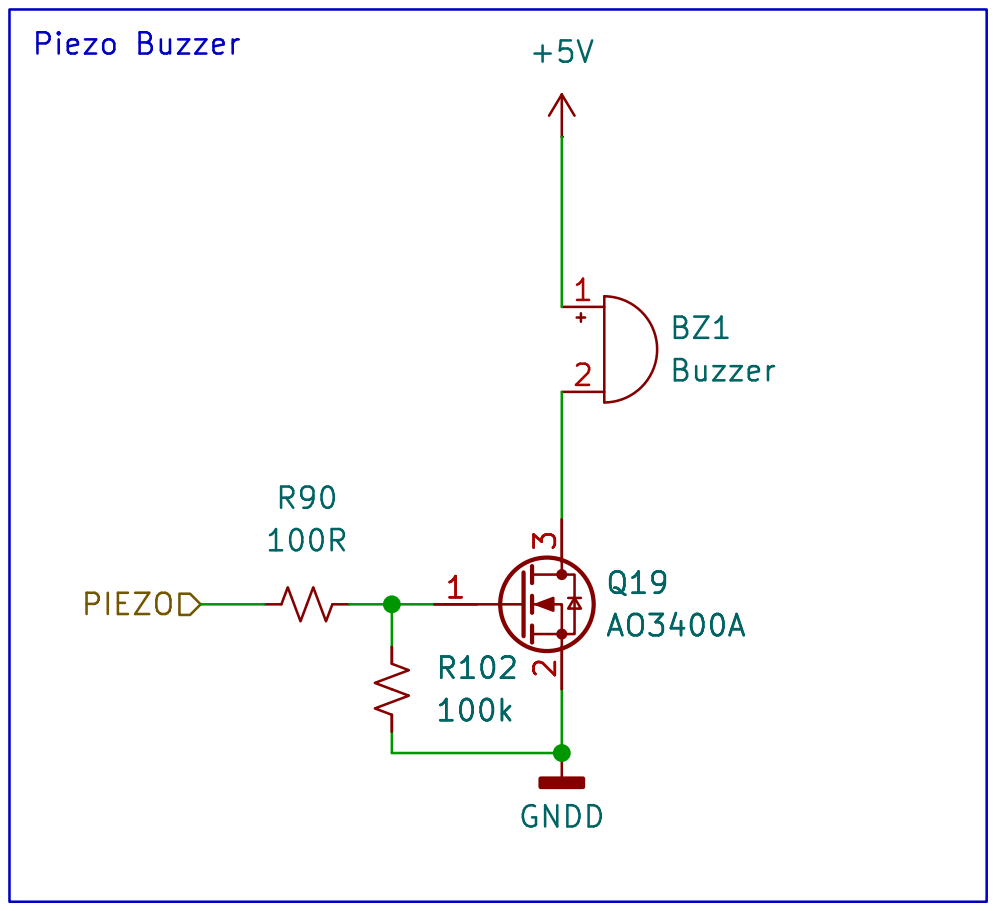
[picture p31: page 13]

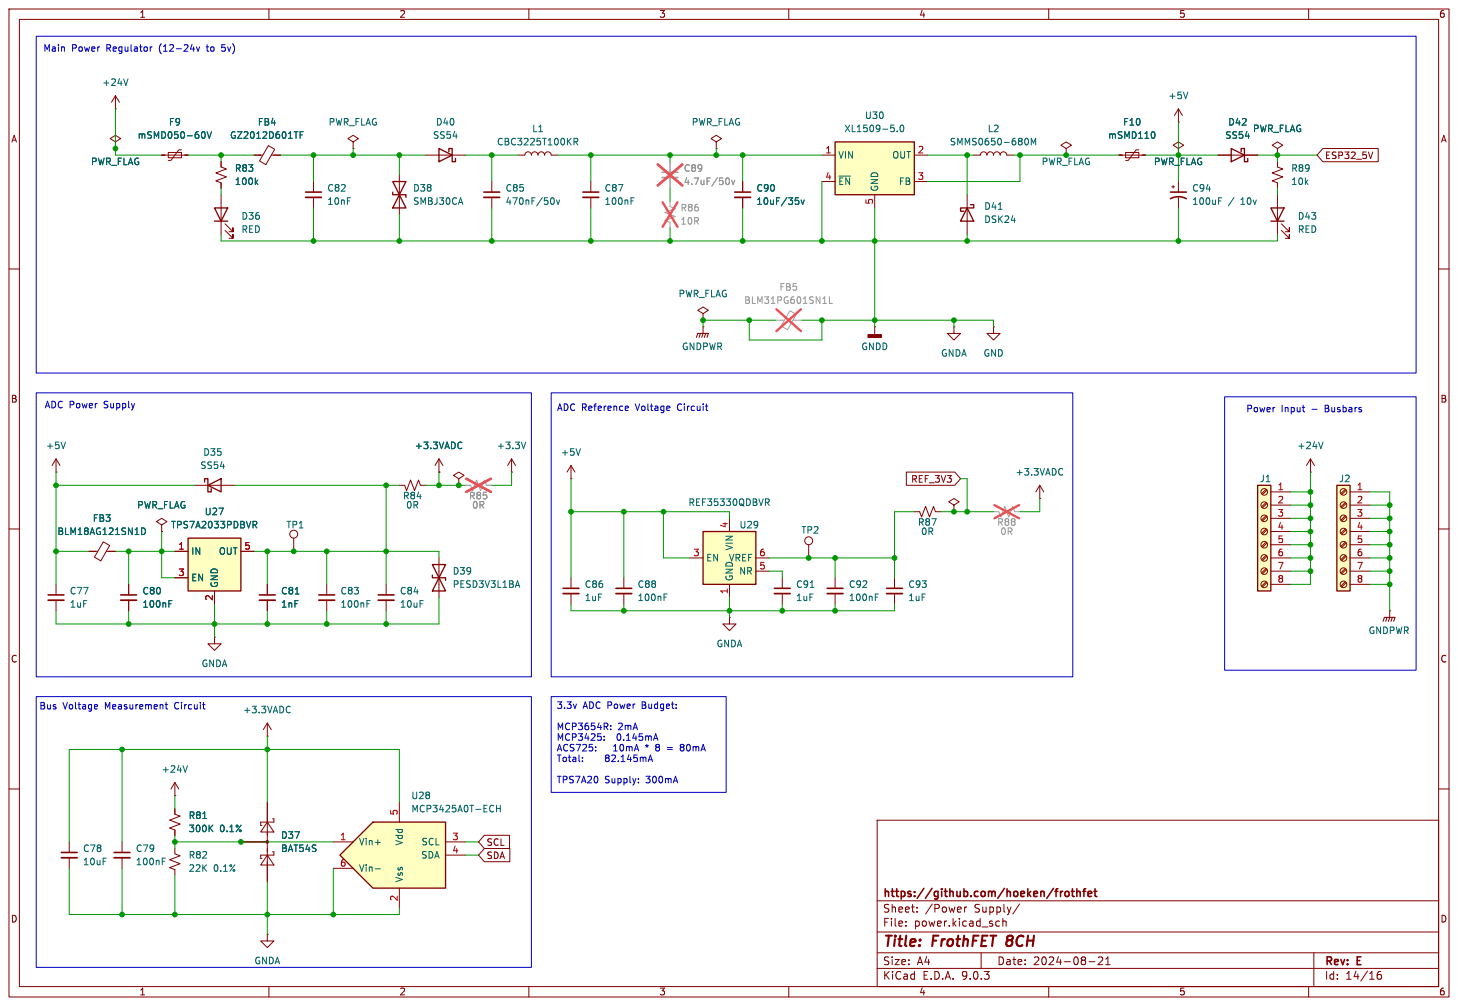
[picture p32: page 14]

5 Vss 2 SCL 3 SDA 4 U28 MCP3425A0T-ECH

https://github.com/hoeken/frothfet
Id: 14/16 Title: FrothFET 8CH

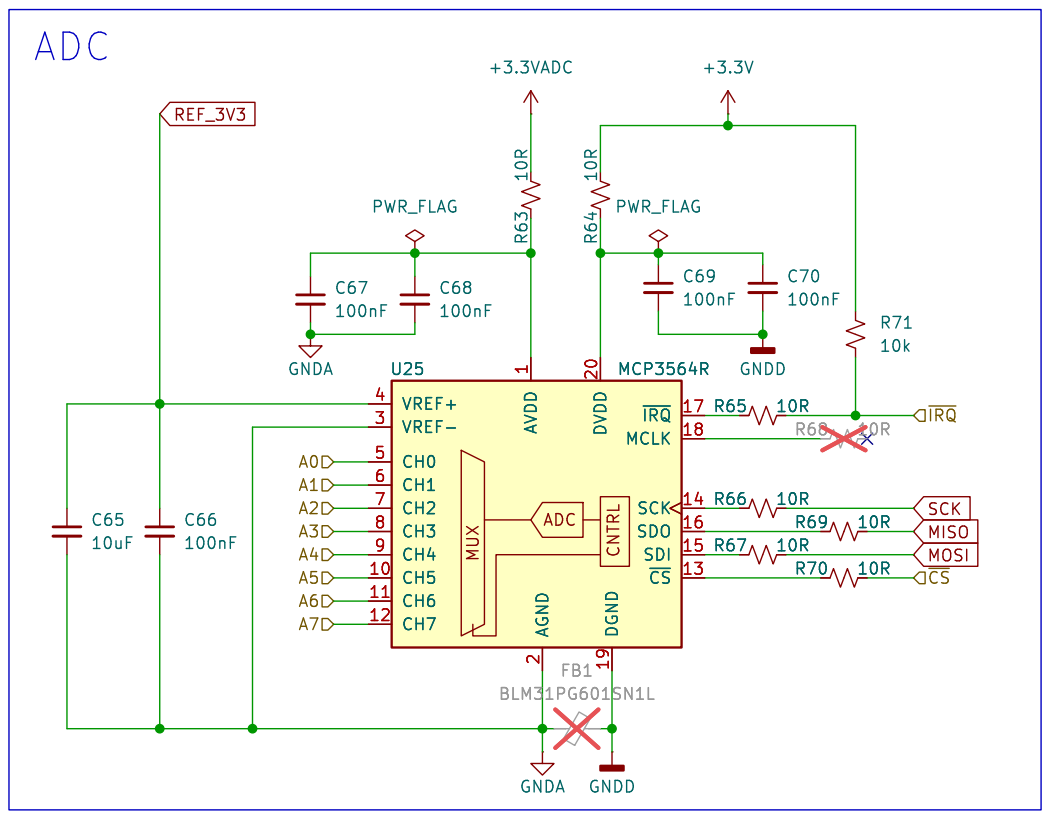
[picture p33: page 15]

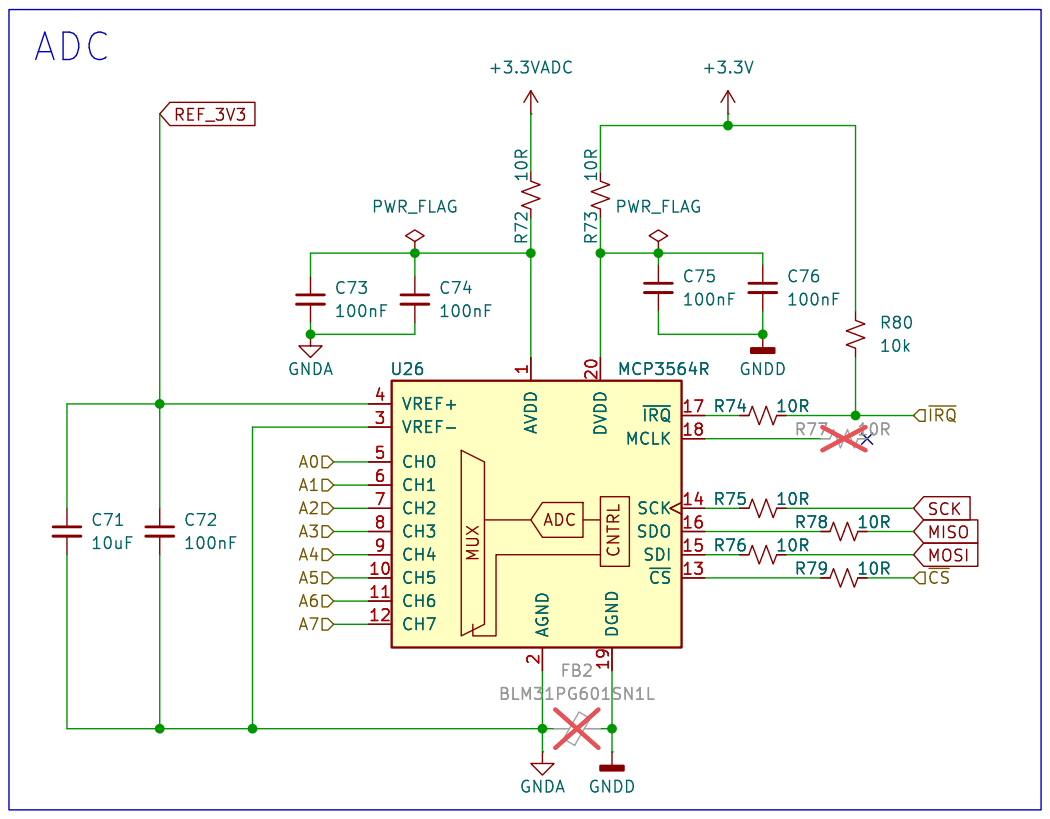
[picture p34: page 16]

File: adc.kicad_sch Sheet: /VOLTAGE ADC/ https://github.com/hoeken/frothfet
