hoeken/frothfet/frothfet/frothfet.kicad_pcb

## KiCad design frothfet/frothfet.kicad_pcb (2026-01-09)

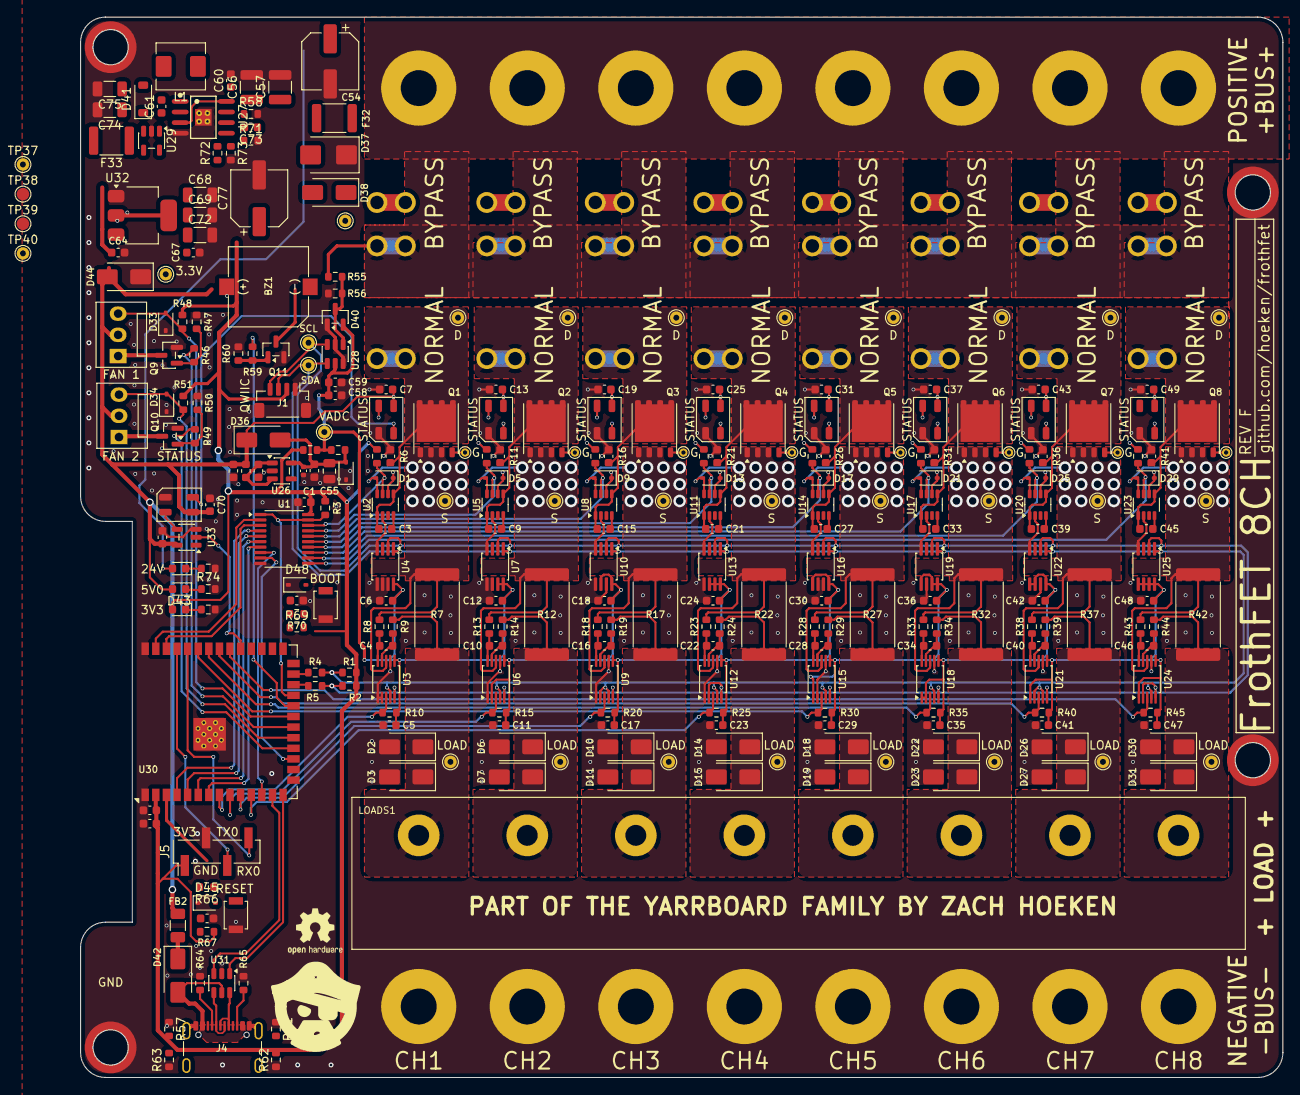
[picture p35: board frothfet.kicad_pcb from above]

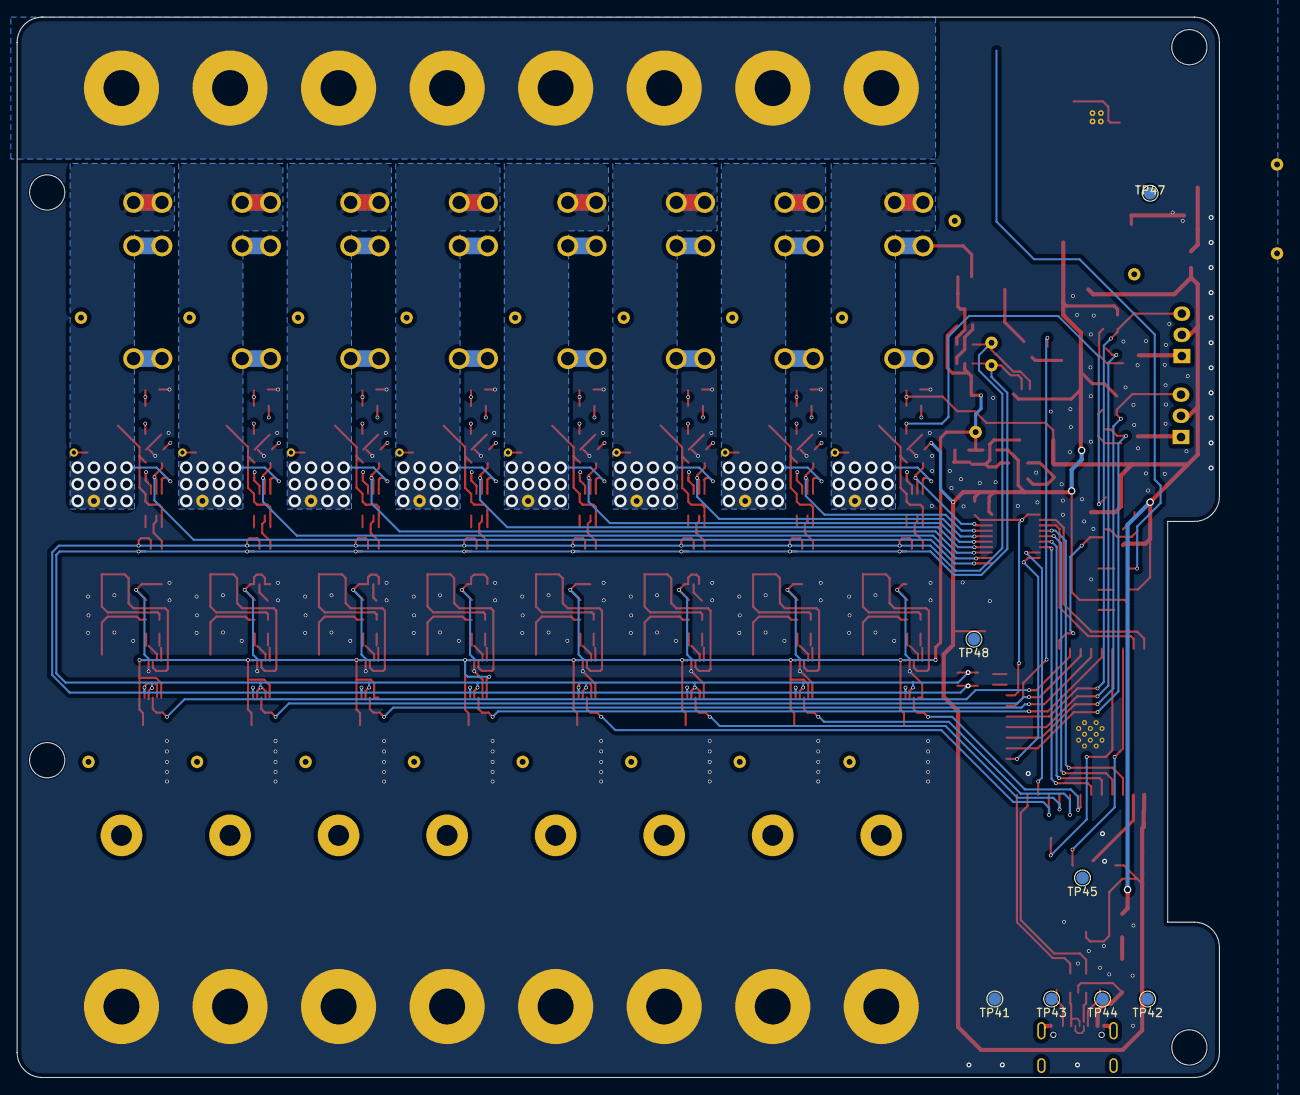
[picture p36: board frothfet.kicad_pcb from below]

Board: 4 copper layers, 144.0 x 127.0 mm, 344 parts (9 on the bottom side), 142 nets.

Parts:
ATC1: 20A; ATC Fuse
BZ1: Buzzer; Buzzer_FUET_9.6x9.6
C1, C2, C4, C5, C6, C7, C8, C10, C11, C12, C13, C14, C16, C17, C18, C19, C20, C22, C23, C24, C25, C26, C28, C29, C30, C31, C32, C34, C35, C36, C37, C38, C40, C41, C42, C43, C44, C46, C47, C48, C49, C51, C53, C59, C60, C61, C63, C65, C70: 100nF; C_0603_1608Metric
C3, C9, C15, C21, C27, C33, C39, C45: 220nF; C_0603_1608Metric
C50, C64, C66, C71: 1uF; C_0603_1608Metric
C52: 1nF; C_0402_1005Metric
C54: 100uF/50v; CP_Elec_6.3x7.7
C55: 10uF; C_0805_2012Metric
C56, C57: 10uF; C_1210_3225Metric
C58: 10uF; C_0603_1608Metric
C62: 22uF; C_0603_1608Metric
C67: 4.7uF; C_0603_1608Metric
C68, C69, C72: 100uF / 6.3v; C_1206_3216Metric
C73: 2.7nF; C_0603_1608Metric
C74, C75: 22uF; C_1206_3216Metric
C77: 220uF / 16v; CP_Elec_6.3x5.4
D1, D5, D9, D13, D17, D21, D25, D29: BZT52C20S; D_SOD-323
D2, D6, D10, D14, D18, D22, D26, D30, D36, D38: SS54; D_SMA
D3, D7, D11, D15, D19, D23, D27, D31: SMAJ30CA; D_SMA
D4, D8, D12, D16, D20, D24, D28, D32, D47: WS2812B-Mini; LED_WS2812B-Mini_PLCC4_3.5x3.5mm
D33, D34, D39, D45, D48: PESD3V3L1BA; D_SOD-323
D35, D43, D46: GREEN; LED_0603_1608Metric
D37: SMBJ30CA; D_SMB
D40: BAV199; SOT-23
D41: 1N4148W; D_SOD-123
D42: SS34; D_SMA
D44: SMAJ5.0A; D_SMA
F1, F2, F3, F5, F6, F7, F9, F10, F11, F13, F14, F15, F17, F18, F19, F21, F22, F23, F25, F26, F27, F29, F30, F31: T508; XFCN T508
F4, F8, F12, F16, F20, F24, F28: 20A; ATC Fuse
F32: 500mA; Fuse_1812_4532Metric
F33: mSMD200; Fuse_1812_4532Metric
FB1: BLM18AG121SN1D; L_0603_1608Metric
FB2: 1.5A; Fuse_1206_3216Metric
H1, H2, H3, H4: SMTSO30XXX
J1: Conn_01x04_MountingPin; JST_SH_BM04B-SRSS-TB_1x04-1MP_P1.00mm_Vertical
J2: Screw_Terminal_01x08; Frothfet Busbar Positive Rev E
J3: Screw_Terminal_01x08; Frothfet Busbar Negative Rev E
J4: USB_TYPE_C_16PIN; USB_C_Receptacle_GCT_USB4105-xx-A_16P_TopMnt_Horizontal
J5: Conn_01x04; PinHeader_1x04_P2.54mm_Vertical_SMD_Pin1Left
L1: 6.8uH; L_Chilisin_BMRA00050530
LOADS1: Screw_Terminal_01x08; KF78S-13.0-8P
LOGO1: Logo_Open_Hardware_Small; Logo Small
LOGO2: Logo_Open_Hardware_Small; OSHW-Logo2_7.3x6mm_SilkScreen
M1, M2: Fan_Tacho; FanPinHeader_1x03_P2.54mm_Vertical
Q1, Q2, Q3, Q4, Q5, Q6, Q7, Q8: BSC010N04LS; Infineon_PG-TDSON-8_6.15x5.15mm
Q9, Q10, Q11: AO3400A; SOT-23
R1, R2: 2.2k; R_0603_1608Metric
R3, R6, R10, R11, R15, R16, R20, R21, R25, R26, R30, R31, R35, R36, R40, R41, R45, R48, R51, R67, R70, R74: 10k; R_0603_1608Metric
R4, R5, R53, R54, R57, R61, R62, R63: 0R; R_0603_1608Metric
R7, R12, R17, R22, R27, R32, R37, R42: 2 mOhm; R_4020_10251Metric
R8, R9, R13, R14, R18, R19, R23, R24, R28, R29, R33, R34, R38, R39, R43, R44: 4.7R 1%; R_0603_1608Metric
R46, R49, R59, R66, R69: 100R; R_0603_1608Metric
R47, R50, R52, R60: 100k; R_0603_1608Metric
R55: 300K 0.1%; R_0603_1608Metric
R56: 22K 0.1%; R_0603_1608Metric
R58: 82k 1%; R_0603_1608Metric
R64, R65, R68: 5.1k; R_0603_1608Metric
R71: 24k; R_0603_1608Metric
R72: 62k 1%; R_0603_1608Metric
R73: 11.8k 1%; R_0603_1608Metric
SW1, SW2: SW_SPST_B3U-1000P
TP1, TP2, TP4, TP5, TP6, TP8, TP9, TP10, TP12, TP13, TP14, TP16, TP17, TP18, TP20, TP21, TP22, TP24, TP25, TP26, TP28, TP29, TP30, TP32, TP33, TP34, TP35, TP36, TP37, TP40, TP46: TestPoint_THTPad_D1.5mm_Drill0.7mm
TP3, TP7, TP11, TP15, TP19, TP23, TP27, TP31: TestPoint_THTPad_D1.0mm_Drill0.5mm
TP38, TP39, TP41, TP42, TP43, TP44, TP45, TP47, TP48: TestPoint; TestPoint_Pad_D1.5mm
U1: 74LVC541A; TSSOP-20_4.4x6.5mm_P0.65mm
U2, U5, U8, U11, U14, U17, U20, U23: LM74502H; SOT-23-8
U3, U6, U9, U12, U15, U18, U21, U24: INA226; VSSOP-10_3x3mm_P0.5mm
U4, U7, U10, U13, U16, U19, U22, U25: LM75BD; MSOP-8_3x3mm_P0.65mm
U26: TPS7A2033PDBVR; SOT-23-5
U27: RT7272BGSP; SOIC-8_L5.0-W4.0-P1.27-LS6.0-BL-EP2.0
U28: MCP3425A0T-ECH; SOT-23-6
U29: MAX40200AUK; SOT-23-5
U30: ESP32-S3-WROOM-1-N16R8; ESP32-S3-WROOM-1
U31: USBLC6-2SC6; SOT-23-6
U32: LDL1117S33R; SOT-223-3_TabPin2
U33: SN74LV1T34DBV; SOT-23-5

Connections:
+3.3V: C1.1, C62.1, C63.1, C67.1, C68.1, C69.1, C72.1, D46.2 (A), J1.2, J5.1, R1.2, R2.2, R3.1, R6.2, R11.2, R16.2, R21.2, R26.2, R31.2, R36.2, R41.2, R48.2, R51.2, R54.2, R67.1, R70.2, TP46.1, TP47.1, U1.20 (VCC), U30.2 (3V3), U32.2 (VO)
+3.3VADC: C5.1, C6.1, C11.1, C12.1, C17.1, C18.1, C23.1, C24.1, C29.1, C30.1, C35.1, C36.1, C41.1, C42.1, C47.1, C48.1, C58.1, C59.1, D40.2 (K), R10.2, R15.2, R20.2, R25.2, R30.2, R35.2, R40.2, R45.2, R53.2, R54.1, TP36.1, U3.6 (VS), U4.8 (+Vs), U6.2 (A0), U6.6 (VS), U7.7 (A0), U7.8 (+Vs), U9.6 (VS), U10.6 (A1), U10.8 (+Vs), U12.6 (VS), U13.6 (A1), U13.7 (A0), U13.8 (+Vs), U15.1 (A1), U15.6 (VS), U16.5 (A2), U16.8 (+Vs), U18.1 (A1), U18.2 (A0), U18.6 (VS), U19.5 (A2), U19.7 (A0), U19.8 (+Vs), U21.1 (A1), U21.6 (VS), U22.5 (A2), U22.6 (A1), U22.8 (+Vs), U24.1 (A1), U24.6 (VS), U25.5 (A2), U25.6 (A1), U25.7 (A0), U25.8 (+Vs), U28.5 (Vdd)
+5V: BZ1.1 (+), C7.2, C13.2, C19.2, C25.2, C31.2, C37.2, C43.2, C49.2, C50.1, C64.1, C65.1, C70.1, C77.1, D4.1 (VDD), D8.1 (VDD), D12.1 (VDD), D16.1 (VDD), D20.1 (VDD), D24.1 (VDD), D28.1 (VDD), D32.1 (VDD), D36.1 (K), D43.2 (A), D44.2 (A2), D47.1 (VDD), FB1.1, FB2.2, M1.2 (+), M2.2 (+), TP39.1, TP40.1, U29.5 (OUT), U32.3 (VI), U33.5 (VCC)
+24V: C54.1, F2.1, F6.1, F10.1, F14.1, F18.1, F22.1, F26.1, F30.1, F32.2, J2.1, J2.2, J2.3, J2.4, J2.5, J2.6, J2.7, J2.8, R55.2
/CHANNEL 1/LED_DOUT: D4.2 (DOUT), D8.4 (DIN)
/CHANNEL 1/LOAD_SWITCHED: D1.2 (A), F3.1, Q1.3 (S), R7.1, R8.2, TP5.1, U2.8 (SRC), U3.8 (Vbus)
/CHANNEL 1/LOAD_VSS: C2.1, C3.1, F1.1, Q1.1 (D), TP4.1, U2.1 (EN/UVLO), U2.5 (VS)
/CHANNEL 2/LED_DOUT: D8.2 (DOUT), D12.4 (DIN)
/CHANNEL 2/LOAD_SWITCHED: D5.2 (A), F7.1, Q2.3 (S), R12.1, R13.2, TP9.1, U5.8 (SRC), U6.8 (Vbus)
/CHANNEL 2/LOAD_VSS: C8.1, C9.1, F5.1, Q2.1 (D), TP8.1, U5.1 (EN/UVLO), U5.5 (VS)
/CHANNEL 3/LED_DOUT: D12.2 (DOUT), D16.4 (DIN)
/CHANNEL 3/LOAD_SWITCHED: D9.2 (A), F11.1, Q3.3 (S), R17.1, R18.2, TP13.1, U8.8 (SRC), U9.8 (Vbus)
/CHANNEL 3/LOAD_VSS: C14.1, C15.1, F9.1, Q3.1 (D), TP12.1, U8.1 (EN/UVLO), U8.5 (VS)
/CHANNEL 4/LED_DOUT: D16.2 (DOUT), D20.4 (DIN)
/CHANNEL 4/LOAD_SWITCHED: D13.2 (A), F15.1, Q4.3 (S), R22.1, R23.2, TP17.1, U11.8 (SRC), U12.8 (Vbus)
/CHANNEL 4/LOAD_VSS: C20.1, C21.1, F13.1, Q4.1 (D), TP16.1, U11.1 (EN/UVLO), U11.5 (VS)
/CHANNEL 5/LED_DOUT: D20.2 (DOUT), D24.4 (DIN)
/CHANNEL 5/LOAD_SWITCHED: D17.2 (A), F19.1, Q5.3 (S), R27.1, R28.2, TP21.1, U14.8 (SRC), U15.8 (Vbus)
/CHANNEL 5/LOAD_VSS: C26.1, C27.1, F17.1, Q5.1 (D), TP20.1, U14.1 (EN/UVLO), U14.5 (VS)
/CHANNEL 6/LED_DOUT: D24.2 (DOUT), D28.4 (DIN)
/CHANNEL 6/LOAD_SWITCHED: D21.2 (A), F23.1, Q6.3 (S), R32.1, R33.2, TP25.1, U17.8 (SRC), U18.8 (Vbus)
/CHANNEL 6/LOAD_VSS: C32.1, C33.1, F21.1, Q6.1 (D), TP24.1, U17.1 (EN/UVLO), U17.5 (VS)
/CHANNEL 7/LED_DOUT: D28.2 (DOUT), D32.4 (DIN)
/CHANNEL 7/LOAD_SWITCHED: D25.2 (A), F27.1, Q7.3 (S), R37.1, R38.2, TP29.1, U20.8 (SRC), U21.8 (Vbus)
/CHANNEL 7/LOAD_VSS: C38.1, C39.1, F25.1, Q7.1 (D), TP28.1, U20.1 (EN/UVLO), U20.5 (VS)
/CHANNEL 8/LOAD_SWITCHED: D29.2 (A), F31.1, Q8.3 (S), R42.1, R43.2, TP33.1, U23.8 (SRC), U24.8 (Vbus)
/CHANNEL 8/LOAD_VSS: C44.1, C45.1, F29.1, Q8.1 (D), TP32.1, U23.1 (EN/UVLO), U23.5 (VS)
/ESP32-S3/CC1_1: J4.A5 (CC1), R64.1
/ESP32-S3/CC2_1: J4.B5 (CC2), R65.1
/ESP32-S3/EN: R66.2, TP45.1, U30.3 (EN)
/ESP32-S3/ESP_RXD0: J5.4, U30.36 (RXD0)
/ESP32-S3/ESP_TXD0: J5.3, U30.37 (TXD0)
/ESP32-S3/ESP_USB+: U30.14 (USB_D+), U31.1 (I/O1)
/ESP32-S3/ESP_USB-: U30.13 (USB_D-), U31.3 (I/O2)
/ESP32-S3/GPIO0_BOOT: R69.2, TP48.1, U30.27 (IO0)
/ESP32-S3/GPIO1: U1.2 (A0), U30.39 (IO1)
/ESP32-S3/GPIO2: U1.3 (A1), U30.38 (IO2)
/ESP32-S3/GPIO4: U1.4 (A2), U30.4 (IO4)
/ESP32-S3/GPIO5: U1.5 (A3), U30.5 (IO5)
/ESP32-S3/GPIO6: U1.6 (A4), U30.6 (IO6)
/ESP32-S3/GPIO7: U1.7 (A5), U30.7 (IO7)
/ESP32-S3/GPIO8: U1.8 (A6), U30.12 (IO8)
/ESP32-S3/GPIO9: U1.9 (A7), U30.17 (IO9)
/ESP32-S3/GPIO21: R3.2, U1.1 (G1), U1.19 (G2), U30.23 (IO21)
/ESP32-S3/GPIO38: U30.31 (IO38), U33.2 (A)
/ESP32-S3/GPIO47: R4.1, U30.24 (IO47)
/ESP32-S3/GPIO48: R5.2, U30.25 (IO48)
/ESP32-S3/USB_D+: J4.A6 (D+), J4.B6 (D+), TP43.1, U31.6 (I/O1)
/ESP32-S3/USB_D-: J4.A7 (D-), J4.B7 (D-), TP44.1, U31.4 (I/O2)
/ESP32-S3/VBUS: D42.2 (A), J4.A4 (VBUS), J4.A9 (VBUS), J4.B4 (VBUS), J4.B9 (VBUS), TP42.1, U31.5 (VBUS)
/Power Supply/SW: C61.2, L1.1, U27.1 (SW)
ALERT1: R10.1, U3.3 (~Alert), U30.8 (IO15)
ALERT2: R15.1, U6.3 (~Alert), U30.9 (IO16)
ALERT3: R20.1, U9.3 (~Alert), U30.10 (IO17)
ALERT4: R25.1, U12.3 (~Alert), U30.11 (IO18)
ALERT5: R30.1, U15.3 (~Alert), U30.35 (IO42)
ALERT6: R35.1, U18.3 (~Alert), U30.34 (IO41)
ALERT7: R40.1, U21.3 (~Alert), U30.33 (IO40)
ALERT8: R45.1, U24.3 (~Alert), U30.32 (IO39)
CHANNEL_LEDS: D4.4 (DIN), D47.2 (DOUT)
FAN_MOSFET1: R46.2, U30.20 (IO12)
FAN_MOSFET2: R49.2, U30.18 (IO10)
FAN_TACH1: D33.2 (A2), M1.3 (Tacho), R48.1, U30.21 (IO13)
FAN_TACH2: D34.2 (A2), M2.3 (Tacho), R51.1, U30.19 (IO11)
GND: C1.2, C2.2, C5.2, C6.2, C7.1, C8.2, C11.2, C12.2, C13.1, C14.2, C17.2, C18.2, C19.1, C20.2, C23.2, C24.2, C25.1, C26.2, C29.2, C30.2, C31.1, C32.2, C35.2, C36.2, C37.1, C38.2, C41.2, C42.2, C43.1, C44.2, C47.2, C48.2, C49.1, C50.2, C51.2, C52.2, C53.2, C54.2, C55.2, C56.2, C57.2, C58.2, C59.2, C60.2, C62.2, C63.2, C64.2, C65.2, C66.2, C67.2, C68.2, C69.2, C70.2, C71.1, C72.2, C74.2, C75.2, C77.2, D2.2 (A), D3.2 (A2), D4.3 (VSS), D6.2 (A), D7.2 (A2), D8.3 (VSS), D10.2 (A), D11.2 (A2), D12.3 (VSS), D14.2 (A), D15.2 (A2), D16.3 (VSS), D18.2 (A), D19.2 (A2), D20.3 (VSS), D22.2 (A), D23.2 (A2), D24.3 (VSS), D26.2 (A), D27.2 (A2), D28.3 (VSS), D30.2 (A), D31.2 (A2), D32.3 (VSS), D33.1 (A1), D34.1 (A1), D37.1 (A1), D39.1 (A1), D40.1 (A), D44.1 (A1), D45.1 (A1), D47.3 (VSS), D48.1 (A1), H1.1, H2.1, H3.1, H4.1, J1.1, J1.MP (MountPin), J3.1, J3.2, J3.3, J3.4, J3.5, J3.6, J3.7, J3.8, J4.A1 (GND), J4.A12 (GND), J4.B1 (GND), J4.B12 (GND), J5.2, Q9.2 (S), Q10.2 (S), Q11.2 (S), R47.2, R50.2, R52.2, R56.1, R57.1, R58.2, R60.2, R61.1, R62.1, R63.1, R64.2, R65.2, R68.2, R71.2, R73.2, R74.2, SW1.2, SW2.2, TP41.1, U1.10 (GND), U2.2 (GND), U3.1 (A1), U3.2 (A0), U3.7 (GND), U4.4 (GND), U4.5 (A2), U4.6 (A1), U4.7 (A0), U5.2 (GND), U6.1 (A1), U6.7 (GND), U7.4 (GND), U7.5 (A2), U7.6 (A1), U8.2 (GND), U9.1 (A1), U9.7 (GND), U10.4 (GND), U10.5 (A2), U10.7 (A0), U11.2 (GND), U12.1 (A1), U12.7 (GND), U13.4 (GND), U13.5 (A2), U14.2 (GND), U15.2 (A0), U15.7 (GND), U16.4 (GND), U16.6 (A1), U16.7 (A0), U17.2 (GND), U18.7 (GND), U19.4 (GND), U19.6 (A1), U20.2 (GND), U21.7 (GND), U22.4 (GND), U22.7 (A0), U23.2 (GND), U24.7 (GND), U25.4 (GND), U26.2 (GND), U27.4 (GND), U28.2 (Vss), U28.6 (Vin-), U29.2 (GND), U30.1 (GND), U30.40 (GND), U30.41 (GND), U31.2 (GND), U32.1 (GND), U33.3 (GND)
LOAD1: D2.1 (K), D3.1 (A1), LOADS1.1, R7.2, R9.2, TP6.1
LOAD2: D6.1 (K), D7.1 (A1), LOADS1.2, R12.2, R14.2, TP10.1
LOAD3: D10.1 (K), D11.1 (A1), LOADS1.3, R17.2, R19.2, TP14.1
LOAD4: D14.1 (K), D15.1 (A1), LOADS1.4, R22.2, R24.2, TP18.1
LOAD5: D18.1 (K), D19.1 (A1), LOADS1.5, R27.2, R29.2, TP22.1
LOAD6: D22.1 (K), D23.1 (A1), LOADS1.6, R32.2, R34.2, TP26.1
LOAD7: D26.1 (K), D27.1 (A1), LOADS1.7, R37.2, R39.2, TP30.1
LOAD8: D30.1 (K), D31.1 (A1), LOADS1.8, R42.2, R44.2, TP34.1
unnamed: BZ1.2 (-), Q11.3 (D)
unnamed: C73.1, R71.1
unnamed: D1.1 (K), Q1.2 (G), TP3.1, U2.6 (GATE)
unnamed: D5.1 (K), Q2.2 (G), TP7.1, U5.6 (GATE)
unnamed: D9.1 (K), Q3.2 (G), TP11.1, U8.6 (GATE)
unnamed: D13.1 (K), Q4.2 (G), TP15.1, U11.6 (GATE)
unnamed: D17.1 (K), Q5.2 (G), TP19.1, U14.6 (GATE)
unnamed: D21.1 (K), Q6.2 (G), TP23.1, U17.6 (GATE)
unnamed: D25.1 (K), Q7.2 (G), TP27.1, U20.6 (GATE)
unnamed: D29.1 (K), Q8.2 (G), TP31.1, U23.6 (GATE)
unnamed: D35.2 (A), D37.2 (A2), D38.2 (A), F32.1, TP35.1
unnamed: D35.1 (K), R52.1
unnamed: C52.1, C53.1, C55.1, D36.2 (A), D39.2 (A2), R53.1, U26.5 (OUT)
unnamed: C56.1, C57.1, C60.1, D38.1 (K), U27.3 (EN), U27.8 (VIN)
unnamed: D40.3 (COM), R55.1, R56.2, U28.1 (Vin+)
unnamed: C74.1, C75.1, D41.2 (A), F33.2, L1.2, R72.1, TP37.1
unnamed: C61.1, D41.1 (K), U27.2 (BOOT)
unnamed: D42.1 (K), FB2.1
unnamed: D43.1 (K), R74.1
unnamed: C66.1, D45.2 (A2), R66.1, R67.2, SW1.1
unnamed: D46.1 (K), R68.1
unnamed: D47.4 (DIN), U33.4 (Y)
unnamed: C71.2, D48.2 (A2), R69.1, R70.1, SW2.1
unnamed: J4.S1 (SHIELD), R57.2, R61.2, R62.2, R63.2
unnamed: M1.1 (-), Q9.3 (D)
unnamed: M2.1 (-), Q10.3 (D)
unnamed: Q9.1 (G), R46.1, R47.1
unnamed: Q10.1 (G), R49.1, R50.1
unnamed: Q11.1 (G), R59.1, R60.1
unnamed: C3.2, U2.4 (VCAP)
unnamed: C4.1, R8.1, U3.10 (Vin+)
unnamed: C4.2, R9.1, U3.9 (Vin-)
unnamed: C9.2, U5.4 (VCAP)
unnamed: C10.1, R13.1, U6.10 (Vin+)
unnamed: C10.2, R14.1, U6.9 (Vin-)
unnamed: C15.2, U8.4 (VCAP)
unnamed: C16.1, R18.1, U9.10 (Vin+)
unnamed: C16.2, R19.1, U9.9 (Vin-)
unnamed: C21.2, U11.4 (VCAP)
unnamed: C22.1, R23.1, U12.10 (Vin+)
unnamed: C22.2, R24.1, U12.9 (Vin-)
unnamed: C27.2, U14.4 (VCAP)
unnamed: C28.1, R28.1, U15.10 (Vin+)
unnamed: C28.2, R29.1, U15.9 (Vin-)
unnamed: C33.2, U17.4 (VCAP)
unnamed: C34.1, R33.1, U18.10 (Vin+)
unnamed: C34.2, R34.1, U18.9 (Vin-)
unnamed: C39.2, U20.4 (VCAP)
unnamed: C40.1, R38.1, U21.10 (Vin+)
unnamed: C40.2, R39.1, U21.9 (Vin-)
unnamed: C45.2, U23.4 (VCAP)
unnamed: C46.1, R43.1, U24.10 (Vin+)
unnamed: C46.2, R44.1, U24.9 (Vin-)
unnamed: C51.1, FB1.2, U26.1 (IN), U26.3 (EN)
unnamed: C73.2, U27.6 (COMP)
unnamed: R72.2, R73.1, U27.5 (FB)
unnamed: R58.1, U27.7 (RLIM)
unnamed: F33.1, TP38.1, U29.1 (VDD), U29.3 (EN)
PIEZO: R59.2, U30.22 (IO14)
PWM1: R6.1, U1.18 (Y0), U2.7 (OV)
PWM2: R11.1, U1.17 (Y1), U5.7 (OV)
PWM3: R16.1, U1.16 (Y2), U8.7 (OV)
PWM4: R21.1, U1.15 (Y3), U11.7 (OV)
PWM5: R26.1, U1.14 (Y4), U14.7 (OV)
PWM6: R31.1, U1.13 (Y5), U17.7 (OV)
PWM7: R36.1, U1.12 (Y6), U20.7 (OV)
PWM8: R41.1, U1.11 (Y7), U23.7 (OV)
SCL: J1.4, R2.1, R4.2, TP1.1, U3.5 (SCL), U4.2 (SCL), U6.5 (SCL), U7.2 (SCL), U9.5 (SCL), U10.2 (SCL), U12.2 (A0), U12.5 (SCL), U13.2 (SCL), U15.5 (SCL), U16.2 (SCL), U18.5 (SCL), U19.2 (SCL), U21.5 (SCL), U22.2 (SCL), U24.2 (A0), U24.5 (SCL), U25.2 (SCL), U28.3 (SCL)
SDA: J1.3, R1.1, R5.1, TP2.1, U3.4 (SDA), U4.1 (SDA), U6.4 (SDA), U7.1 (SDA), U9.2 (A0), U9.4 (SDA), U10.1 (SDA), U12.4 (SDA), U13.1 (SDA), U15.4 (SDA), U16.1 (SDA), U18.4 (SDA), U19.1 (SDA), U21.2 (A0), U21.4 (SDA), U22.1 (SDA), U24.4 (SDA), U25.1 (SDA), U28.4 (SDA)
