hoeken/frothfet/(commit log)

2024-08-16 added kicad files.
    [ADC chips.ods, adc.kicad_sch, assembly.FCStd, bus voltage.kicad_sch, busbar stackup.ods, busbar.FCStd, case bottom.FCStd, connectors.kicad_sch]
2024-08-16 schematic looking clean.
    [adc.kicad_sch, frothfet-12ch.kicad_sch, mosfet.kicad_sch, power.kicad_sch, sender_input.kicad_sch, voltage_adc.kicad_sch]
2024-08-17 updated bom
    [adc.kicad_sch, frothfet-12ch.kicad_sch, mosfet.kicad_sch, power.kicad_sch, pwm fan.kicad_sch, sender_input.kicad_sch, voltage_adc.kicad_sch]
2024-08-17 just need to route it...
    [adc.kicad_sch, frothfet-12ch.kicad_sch, mosfet.kicad_sch, power.kicad_sch, pwm fan.kicad_sch, sender_input.kicad_sch, voltage_adc.kicad_sch]
2024-08-17 starting the mega route.
    [adc.kicad_sch, voltage_adc.kicad_sch]
2024-08-17 fully routed
    [adc.kicad_sch, frothfet-12ch.kicad_sch, voltage_adc.kicad_sch]
2024-08-17 clean drc
    [frothfet-12ch.kicad_sch]
2024-08-17 erc clean
    [adc.kicad_sch, frothfet-12ch.kicad_sch, mosfet.kicad_sch, power.kicad_sch, pwm fan.kicad_sch, sender_input.kicad_sch, voltage_adc.kicad_sch]
2024-08-17 just silkscreen and final review left.
    [mosfet.kicad_sch]
2024-08-17 changed senders to screw terminals
    [sender_input.kicad_sch]
2024-08-17 better esp32-s3 3d model.
2024-08-17 added atc fuses.
2024-08-18 more pre-production tweaks
    [frothfet-12ch.kicad_sch, mosfet.kicad_sch, power.kicad_sch, sender_input.kicad_sch]
2024-08-19 added mosfet thermistor
    [mosfet.kicad_sch]
2024-08-21 lots of big updates
    [adc.kicad_sch, bus voltage.kicad_sch, connectors.kicad_sch, esp32 pin selection.ods, frothfet-12ch.kicad_sch, mosfet.kicad_sch, power.kicad_sch, pwm fan.kicad_sch]
2024-08-21 changed to MIC5014
    [adc.kicad_sch, mosfet.kicad_sch, pwm calculations.ods]
2024-08-26 first pass at ltc7004
    [adc.kicad_sch, frothfet-12ch.kicad_sch, mosfet.kicad_sch, power.kicad_sch, pwm calculations.ods, pwm fan.kicad_sch, voltage_adc.kicad_sch]
2024-10-02 renamed to frothfet.
    [ADC chips.ods, adc.kicad_sch, assembly.FCStd, busbar stackup.ods, busbar.FCStd, case bottom.FCStd, current consumption.ods, current sense chips.ods]
2024-10-02 prep for new HierarchialPCB test
    [adc.kicad_sch, frothfet.kicad_pcb, frothfet.kicad_sch, mosfet.kicad_pcb, mosfet.kicad_sch, power.kicad_sch, pwm fan.kicad_sch, voltage_adc.kicad_sch]
2024-10-02 Revert "prep for new HierarchialPCB test"
    This reverts commit 7ba467f7ba771a9ed3b62c58bdcef6315b0965ad.
    [adc.kicad_sch, frothfet.kicad_pcb, frothfet.kicad_sch, mosfet.kicad_pcb, mosfet.kicad_sch, power.kicad_sch, pwm fan.kicad_sch, voltage_adc.kicad_sch]
2024-10-02 back to a good state
    [adc.kicad_sch, frothfet.kicad_pcb, frothfet.kicad_sch, mosfet.kicad_sch, power.kicad_sch, pwm fan.kicad_sch, voltage_adc.kicad_sch]
2024-10-02 first pass at new subcircuit layout
    [frothfet.kicad_pcb, ltd7004 worksheet.ods, mosfet.kicad_sch]
2024-10-02 resized pcb
    [busbar.FCStd]
2024-10-03 drc passing
    [frothfet.kicad_pcb, frothfet.kicad_sch, mosfet.kicad_sch]
2024-10-03 fatter power trace and layer 3 is fully ground plane now.
    [adc.kicad_sch, frothfet.kicad_pcb, frothfet.kicad_sch, mosfet.kicad_sch, power.kicad_sch, pwm fan.kicad_sch, voltage_adc.kicad_sch]
2024-10-04 updated a couple components, flyback diode.
    [frothfet.kicad_pcb, mosfet.kicad_sch]
2024-10-05 added selector for 3.3VADC and finalized board.
    [adc.kicad_sch, frothfet.kicad_pcb, frothfet.kicad_sch, power.kicad_sch, voltage_adc.kicad_sch]
2024-10-06 wrong led pn
    [mosfet.kicad_sch]
2024-10-23 updated dnp, updatd channel voltage divider, added discharge mosfet circuit
    [frothfet.kicad_pcb, frothfet.kicad_sch, ltd7004 worksheet.ods, mosfet.kicad_sch]
2024-10-25 todo list and rev d testing
    [esp32 pin selection.ods, mosfet.kicad_sch, power.kicad_sch]
2024-10-25 updated voltage divider values
    [mosfet.kicad_sch]
2024-10-25 added power leds
    [power.kicad_sch]
2024-10-25 updated the adc voltage regulator.
    [power.kicad_sch]
2024-10-25 added hole to screw connector
    [frothfet.kicad_pcb]
2024-10-25 added extra adc control lines
    [adc.kicad_sch, esp32 pin selection.ods, frothfet.kicad_pcb, frothfet.kicad_sch, voltage_adc.kicad_sch]
2024-10-25 fans are now simple on/off, cleaned up power supply drawings
    [esp32 pin selection.ods, power.kicad_sch, pwm fan.kicad_sch]
2024-10-26 updated fans and also new "dump" mosfet circuit
    [esp32 pin selection.ods, mosfet.kicad_sch, pwm fan.kicad_sch]
2024-10-26 added piezo buzzer
    [esp32 pin selection.ods, frothfet.kicad_sch, piezo.kicad_sch]
2024-10-26 updated adc and adc power supply schematics.
    [adc.kicad_sch, power.kicad_sch]
2024-10-29 added the up to date rev d schematic
    [FrothFET-Rev-D.kicad_pcb, FrothFET-Rev-D.kicad_sch, adc.kicad_sch, mosfet.kicad_sch, power.kicad_sch, pwm fan.kicad_sch, sender_input.kicad_sch, voltage_adc.kicad_sch]
2024-10-30 tweaks to rev d
    [FrothFET-Rev-D.kicad_pcb, mosfet.kicad_sch, power.kicad_sch]
2024-10-30 rev e channel changes.
    [adc.kicad_sch, frothfet.kicad_sch, mosfet.kicad_sch, piezo.kicad_sch, power.kicad_sch, pwm fan.kicad_sch, voltage_adc.kicad_sch]
2024-10-30 consolidated on a single adc
    [adc.kicad_sch, frothfet.kicad_sch]
2024-10-31 updated the dummy load schematic.
    [adc.kicad_sch, frothfet.kicad_pcb, frothfet.kicad_sch, mosfet.kicad_sch, piezo.kicad_sch, power.kicad_sch, pwm fan.kicad_sch]
2024-11-01 removed uvlo resistor, tied to gnd.
    [mosfet.kicad_sch]
2024-11-01 updated pins: channel rgbs + channel 5+6 pwm pins
    [esp32 pin selection.ods, frothfet.kicad_sch]
2024-11-01 changed to jumper resistor for voltage selection.
    [power.kicad_sch]
2024-11-01 re-calculate channel voltage divider <= 30k and 3.3v output
    [mosfet.kicad_sch]
2024-11-01 recalculate values for adc filters - 1khz should be fine
    [mosfet.kicad_sch]
2024-11-02 started work on rev e, looking clean at 13mm
    [adc.kicad_sch, frothfet.kicad_pcb, frothfet.kicad_sch, mosfet.kicad_sch, piezo.kicad_sch, power.kicad_sch, pwm fan.kicad_sch]
2024-11-02 more progress on the next rev.
    [busbar.FCStd, frothfet.kicad_pcb, mosfet.kicad_sch, power.kicad_sch]
2024-11-02 layout of the mosfet channel passives looking good.
    [frothfet.kicad_pcb, mosfet.kicad_sch]
2024-11-02 progress - new channel layout good, zones + edges + holes fixed.
    [frothfet.kicad_pcb]
2024-11-02 changed to 0603 and various tweaks
    [adc.kicad_sch, esp32 pin selection.ods, frothfet.kicad_pcb, frothfet.kicad_sch, mosfet.kicad_sch, piezo.kicad_sch, power.kicad_sch, pwm fan.kicad_sch]
2024-11-02 24v to fuse now on both sides.
    [frothfet.kicad_pcb]
2025-07-31 updated to kicad v9
    [adc.kicad_sch, frothfet.kicad_pcb, frothfet.kicad_sch, mosfet.kicad_sch, piezo.kicad_sch, power.kicad_sch, pwm fan.kicad_sch]
2025-07-31 updated todo.
    [frothfet.kicad_sch]
2025-08-15 started the process of re-layout
    [frothfet.kicad_pcb]
2025-08-16 almost ready for routing.
    [adc.kicad_sch, esp32 pin selection.ods, frothfet.kicad_pcb, frothfet.kicad_sch]
2025-09-10 added new esp32-s3 template and switched to lm74502 mosfet driver.
    [esp32-s3.kicad_sch, frothfet.kicad_pcb, frothfet.kicad_sch, mosfet.kicad_sch, pwm calculations.ods]
2025-09-11 updated calculations, updated esp32-s3 schematic, updated layout.
    [esp32-s3.kicad_sch, frothfet.kicad_pcb, frothfet.kicad_sch, pwm calculations.ods]
2025-09-12 worked on 3d models for all parts.
    [frothfet.kicad_pcb, frothfet.kicad_sch, mosfet.kicad_sch, power.kicad_sch]
2025-09-13 worked on the bom and footprint placement
    [adc.kicad_sch, esp32-s3.kicad_sch, frothfet.kicad_pcb, frothfet.kicad_sch, mosfet.kicad_sch, piezo.kicad_sch, power.kicad_sch, pwm fan.kicad_sch]
2025-09-27 changed the adc voltage regulator and vref to more common parts.
    [adc.kicad_sch, frothfet.kicad_pcb, power.kicad_sch]
2025-09-28 lots of work on the analog system
    [adc.kicad_sch, esp32-s3.kicad_sch, frothfet.kicad_pcb, frothfet.kicad_sch, mosfet.kicad_sch, piezo.kicad_sch, power.kicad_sch, pwm fan.kicad_sch]
2025-09-30 moved back to a single ground plane
    [adc.kicad_sch, frothfet.kicad_pcb, mosfet.kicad_sch, power.kicad_sch]
2025-10-01 cant remember
    [frothfet.kicad_pcb, frothfet.kicad_sch, mosfet.kicad_sch, power.kicad_sch, pwm calculations.ods]
2025-10-02 imported latest esp32-s3 module
    [adc.kicad_sch, esp32-s3.kicad_sch, frothfet.kicad_pcb, frothfet.kicad_sch, mosfet.kicad_sch, piezo.kicad_sch, power.kicad_sch, pwm fan.kicad_sch]
2025-10-02 piezo resistor
    [frothfet.kicad_pcb, piezo.kicad_sch]
2025-10-04 about 50% routed
    [esp32-s3.kicad_sch, frothfet.kicad_pcb, mosfet.kicad_sch, pwm fan.kicad_sch]
2025-10-04 finished re-routing the board.
    [frothfet.kicad_pcb, frothfet.kicad_sch]
2025-10-04 silkscreen done, erc+drc passing
    [adc.kicad_sch, frothfet.kicad_pcb, frothfet.kicad_sch, mosfet.kicad_sch, piezo.kicad_sch, power.kicad_sch, pwm fan.kicad_sch]
2025-10-04 via stitching done.
    [frothfet.kicad_pcb]
2025-10-04 bom and placement all check out. ready for production!
    [esp32-s3.kicad_sch, frothfet.kicad_pcb, frothfet.kicad_sch, mosfet.kicad_sch, piezo.kicad_sch, power.kicad_sch]
2025-10-05 rounded board edges
    [frothfet.kicad_pcb]
2025-10-06 updated busbar design and added button silkscreen
    [assembly.FCStd, busbar.FCStd, case bottom.FCStd, frothfet.kicad_pcb, negative-busbar.FCStd, positive-busbar.FCStd, power.kicad_sch, terminal cover.FCStd]
2025-10-07 send the board for production
    [frothfet.kicad_pcb]
2025-10-08 tidy up for Rev E release
    [FrothFET-Rev-D.kicad_pcb, FrothFET-Rev-D.kicad_sch, adc.kicad_sch, mosfet.kicad_sch, negative-busbar.FCStd, positive-busbar.FCStd, power.kicad_sch, pwm fan.kicad_sch]
2025-11-06 updated todo for Rev F design
    [ina226 calculations.ods, pwm calculations.ods]
2025-12-03 pulled in updated esp32-s3 schematic
    [adc.kicad_sch, esp32-s3.kicad_sch, frothfet.kicad_pcb, frothfet.kicad_sch, mosfet.kicad_sch, piezo.kicad_sch, power.kicad_sch, pwm fan.kicad_sch]
2025-12-03 removed adc and adc vref
    [adc.kicad_sch, frothfet.kicad_sch, power.kicad_sch]
2025-12-03 removed unneccesary bleed circuit
    [frothfet.kicad_pcb, mosfet.kicad_sch, power.kicad_sch]
2025-12-03 switched to ina226 for voltage and current measurement
    [mosfet.kicad_sch]
2025-12-03 added lm75b temperature sensor to channels.
    [mosfet.kicad_sch]
2025-12-03 wired the i2c addresses.
    [esp32-s3.kicad_sch, frothfet.kicad_pcb, frothfet.kicad_sch, mosfet.kicad_sch, piezo.kicad_sch, power.kicad_sch, pwm fan.kicad_sch]
2025-12-03 added the buffer circuit
    [esp32-s3.kicad_sch, frothfet.kicad_pcb, frothfet.kicad_sch, mosfet.kicad_sch, piezo.kicad_sch, power.kicad_sch, pwm fan.kicad_sch]
2025-12-03 added ideal diode to 5v
    [power.kicad_sch]
2025-12-03 added bulk capacitor on 24v
    [power.kicad_sch]
2025-12-03 power supply tweaks and tidy
    [power.kicad_sch]
2025-12-04 changed to a single ground
    [frothfet.kicad_pcb, frothfet.kicad_sch, mosfet.kicad_sch, piezo.kicad_sch, power.kicad_sch, pwm fan.kicad_sch]
2025-12-04 added test points
    [esp32-s3.kicad_sch, frothfet.kicad_pcb, frothfet.kicad_sch, mosfet.kicad_sch, piezo.kicad_sch, power.kicad_sch, pwm fan.kicad_sch]
2025-12-04 worked on routing load channel.
    [esp32-s3.kicad_sch, frothfet.kicad_pcb, frothfet.kicad_sch, mosfet.kicad_sch, piezo.kicad_sch, power.kicad_sch, pwm fan.kicad_sch]
2025-12-04 this is gonna be a beast to route
    [frothfet.kicad_pcb]
2025-12-05 ready for multi channel work
    [frothfet.kicad_pcb, mosfet.kicad_sch]
2025-12-05 channel zones are looking good.
    [frothfet.kicad_pcb]
2025-12-05 channel routing is looking good.
    [frothfet.kicad_pcb]
2025-12-05 double checked i2c capacitance
    [frothfet.kicad_pcb, frothfet.kicad_sch]
2025-12-05 channel routing is basically done
    [esp32-s3.kicad_sch, frothfet.kicad_pcb, frothfet.kicad_sch, mosfet.kicad_sch, piezo.kicad_sch, power.kicad_sch, pwm fan.kicad_sch]
2025-12-05 starting to layout the rest of the components.
    [esp32-s3.kicad_sch, frothfet.kicad_pcb, frothfet.kicad_sch, mosfet.kicad_sch, piezo.kicad_sch, power.kicad_sch, pwm fan.kicad_sch]
2025-12-06 mostly routed
    [frothfet.kicad_pcb, power.kicad_sch]
2025-12-06 added via stitching
    [frothfet.kicad_pcb]
2025-12-06 drc errors fixed.
    [frothfet.kicad_pcb, frothfet.kicad_sch, mosfet.kicad_sch]
2025-12-06 silkscreen and 3d models complete
    [esp32-s3.kicad_sch, frothfet.kicad_pcb]
2025-12-06 added some lcsc part numbers
    [esp32-s3.kicad_sch, frothfet.kicad_pcb, frothfet.kicad_sch]
2025-12-06 caught a bug with pulldown instead of pullup on LM74502H
    [frothfet.kicad_pcb, mosfet.kicad_sch]
2025-12-07 added more esd protection to 3.3v and 5v rails.
    [esp32-s3.kicad_sch, frothfet.kicad_pcb, mosfet.kicad_sch, piezo.kicad_sch, power.kicad_sch, pwm fan.kicad_sch]
2025-12-07 added support for ALERT pin from INA226 for overcurrent protection (hopefully)
    [esp32-s3.kicad_sch, frothfet.kicad_pcb, frothfet.kicad_sch, mosfet.kicad_sch, piezo.kicad_sch, power.kicad_sch, pwm calculations.ods, pwm fan.kicad_sch]
2025-12-07 rearranged the buttons
    [esp32-s3.kicad_sch, frothfet.kicad_pcb]
2025-12-07 rearranged leds and cleaned things up a bit.
    [esp32-s3.kicad_sch, frothfet.kicad_pcb, frothfet.kicad_sch, mosfet.kicad_sch, piezo.kicad_sch, power.kicad_sch, pwm fan.kicad_sch]
2025-12-07 working on bom
    [esp32-s3.kicad_sch, frothfet.kicad_pcb, frothfet.kicad_sch, mosfet.kicad_sch, power.kicad_sch]
2025-12-07 changed to XFCN 508 because 507 wasnt available on jlc
    [esp32-s3.kicad_sch, mosfet.kicad_sch, power.kicad_sch]
2025-12-08 re-routed everything again
    [power.kicad_sch]
2025-12-08 tidied up the power schematic a little bit.
    [power.kicad_sch]
2025-12-08 fixed a minor zone spacing issue
    [frothfet.kicad_pcb]
2025-12-08 swapped piezo and output enable due to power on glitch on gpio14
    [frothfet.kicad_pcb, frothfet.kicad_sch]
2025-12-08 changed buffer to 74LVC541A
    [frothfet.kicad_pcb, frothfet.kicad_sch]
2025-12-08 notes on gate driver
    [mosfet.kicad_sch]
2025-12-12 add esd protection to each channel output
    [esp32-s3.kicad_sch, mosfet.kicad_sch, power.kicad_sch, pwm fan.kicad_sch]
2025-12-12 placement and routing plan for channels is fixed.
    [frothfet.kicad_sch]
2025-12-12 small schematic cleanup
    [mosfet.kicad_sch]
2025-12-12 pulled in latest version of esp32 schematic
    [esp32-s3.kicad_sch, frothfet.kicad_pcb, mosfet.kicad_sch, power.kicad_sch]
2025-12-12 updated datasheets
    [frothfet.kicad_sch, mosfet.kicad_sch, piezo.kicad_sch]
2025-12-12 switched to bav199 on bus voltage
    [frothfet.kicad_pcb, power.kicad_sch]
2025-12-12 added via stitching back in
    [frothfet.kicad_pcb]
2025-12-13 updated bom and checked placement
    [esp32-s3.kicad_sch, frothfet.kicad_pcb, frothfet.kicad_sch, mosfet.kicad_sch, piezo.kicad_sch, power.kicad_sch, pwm fan.kicad_sch]
2026-01-09 updated esp32-s3 schematic
    [esp32-s3.kicad_sch, frothfet.kicad_pcb]
2026-01-09 update 24v to 5v power supply with brineomatic one
    [frothfet.kicad_pcb, power.kicad_sch]
2026-01-10 finished routing the board.
2026-01-10 finished vias, added a bunch of test points
    [esp32-s3.kicad_sch, mosfet.kicad_sch, power.kicad_sch, pwm fan.kicad_sch]
2026-01-10 silkscreen done
    [esp32-s3.kicad_sch, frothfet.kicad_sch, mosfet.kicad_sch, piezo.kicad_sch, power.kicad_sch, pwm fan.kicad_sch]
2026-01-10 bom and placement looking good.
    [esp32-s3.kicad_sch, frothfet.kicad_sch, mosfet.kicad_sch, power.kicad_sch, pwm fan.kicad_sch]
2026-01-10 switch back to T507 fuse holder is complete
    [esp32-s3.kicad_sch, frothfet.kicad_sch, mosfet.kicad_sch, power.kicad_sch]
2026-01-10 a few routing tweaks, removed DNP on pin headers for uart0
    [esp32-s3.kicad_sch, mosfet.kicad_sch]
2026-01-12 added fuse p/n and drawing
    [mosfet.kicad_sch]
2026-01-15 final bom tweaks for manufacturing
    [esp32-s3.kicad_sch, mosfet.kicad_sch]
2026-04-01 added the Rev F case
2026-04-13 added spreadsheet
    [cost reduction.ods]
2026-04-14 added Rev F schematic
2026-04-16 renamed bus bar source
    [Negative Busbar Rev F.FCStd, Positive Busbar Rev F.FCStd]
2026-05-05 updated with plans for a frothfet mini board.
    [cost reduction.ods]
